DerSchweigefuchs/uC_Agri-PV/Bibliothek/ESP32-C6-WROOM-1-N8/ESP32-C6-WROOM-1-N8.step

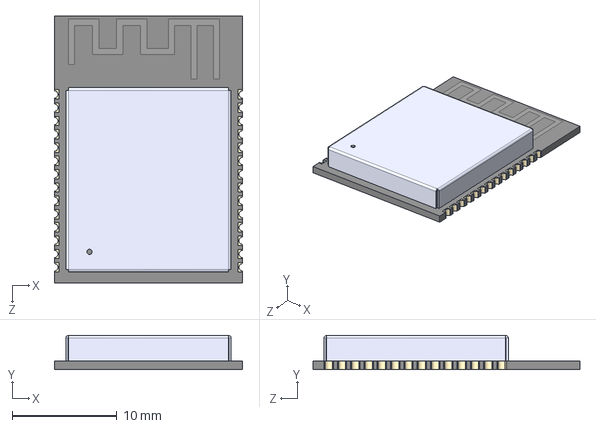
[picture p10: CAD file, 2025-12-17]
Bibliothek/ESP32-C6-WROOM-1-N8/ESP32-C6-WROOM-1-N8.step
18.0 x 3.25 x 25.5 mm
