DerSchweigefuchs/uC_Agri-PV/Bibliothek/FC0V104ZFTBR24/3D/FC0V104ZFTBR24.stp

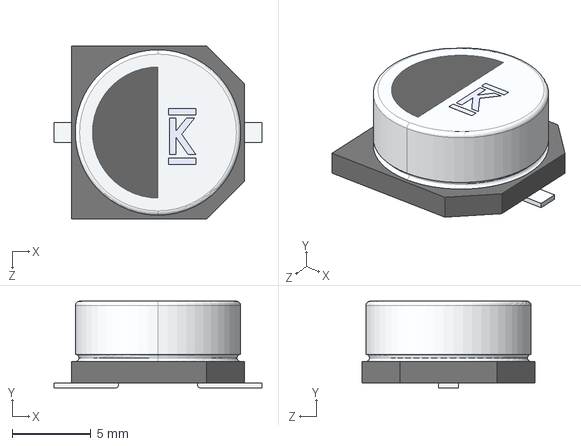
[picture p11: CAD file, 2026-01-08]
Bibliothek/FC0V104ZFTBR24/3D/FC0V104ZFTBR24.stp
13.2 x 5.50 x 11.0 mm
