DerSchweigefuchs/uC_Agri-PV/Bibliothek/LIB_BD125-10-A-0305-0580-L-B/BD125-10-A-0305-0580-L-B/3D/BD125-10-A-0305-0580-L-B.stp

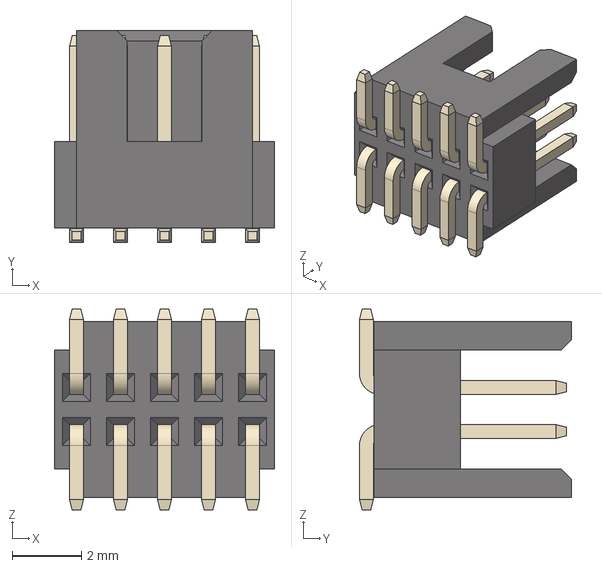
[picture p12: CAD file, 2025-12-17]
Bibliothek/LIB_BD125-10-A-0305-0580-L-B/BD125-10-A-0305-0580-L-B/3D/BD125-10-A-0305-0580-L-B.stp
6.35 x 6.12 x 5.80 mm
BD125-10-A-0305-0580-L-B_H
BD125-10-A-0305-0580-L-B_P x 10
