DerSchweigefuchs/uC_Agri-PV/Bibliothek/LIB_CONSMA001-SMD-G-T/CONSMA001-SMD-G-T/3D/CONSMA001-SMD-G-T.stp

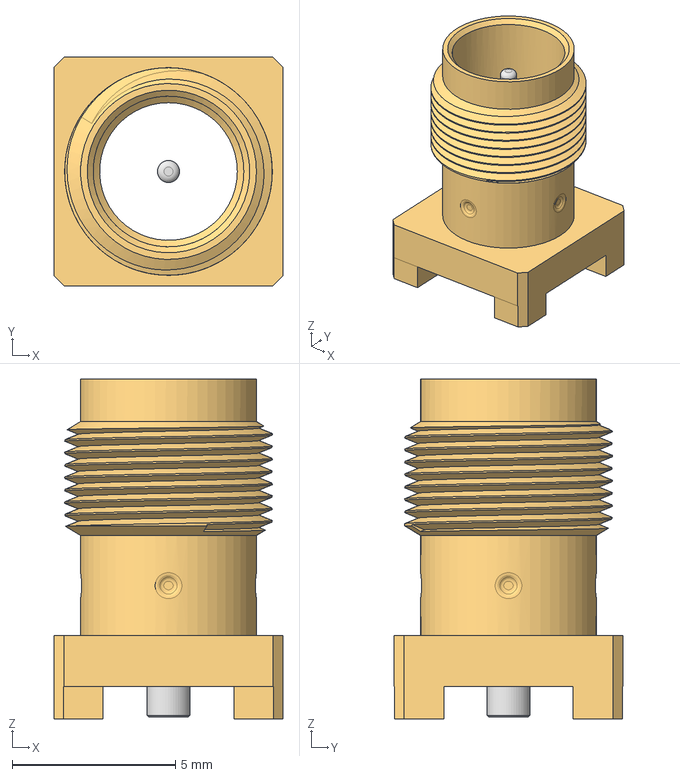
[picture p13: CAD file, 2025-12-17]
Bibliothek/LIB_CONSMA001-SMD-G-T/CONSMA001-SMD-G-T/3D/CONSMA001-SMD-G-T.stp
7.00 x 7.00 x 10.4 mm
