DerSchweigefuchs/uC_Agri-PV/Bibliothek/LIB_DMG1012T-13/DMG1012T-13/3D/DMG1012T-13.stp

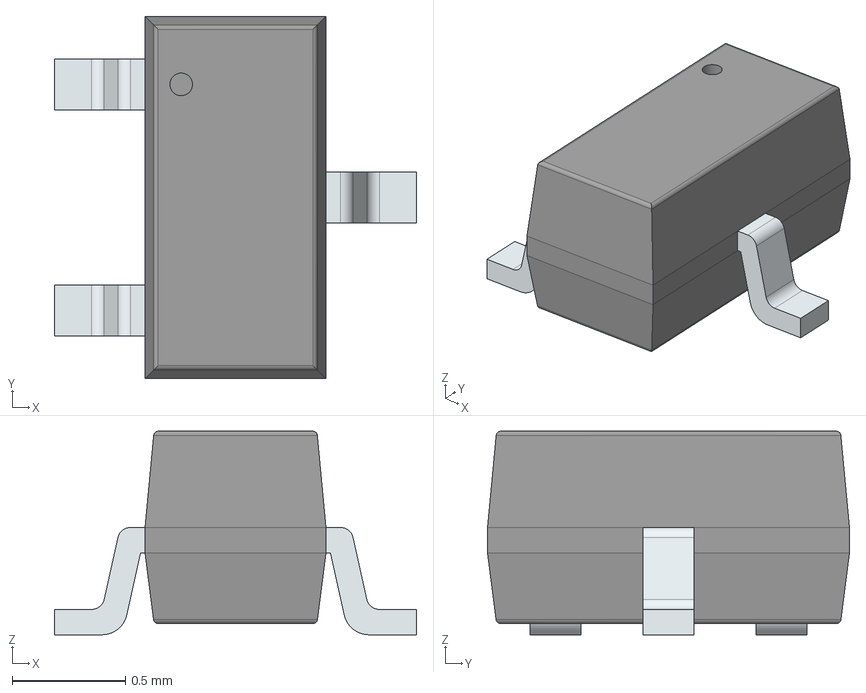
[picture p14: CAD file, 2025-12-17]
Bibliothek/LIB_DMG1012T-13/DMG1012T-13/3D/DMG1012T-13.stp
1.60 x 1.60 x 0.9 mm
PinsArrayL
FilletPinR
