DerSchweigefuchs/uC_Agri-PV/Bibliothek/LIB_DMP1045U-7/DMP1045U-7/3D/DMP1045U-7.stp

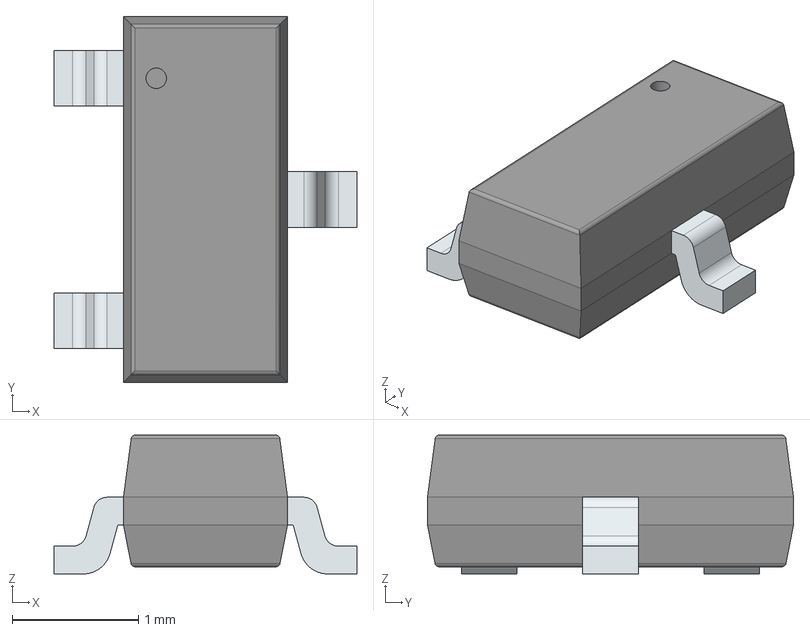
[picture p15: CAD file, 2026-01-08]
Bibliothek/LIB_DMP1045U-7/DMP1045U-7/3D/DMP1045U-7.stp
2.40 x 2.90 x 1.10 mm
PinsArrayL
FilletPinR
