DerSchweigefuchs/uC_Agri-PV/Bibliothek/LIB_ESDALC6V1W5/ESDALC6V1W5/3D/ESDALC6V1W5.stp

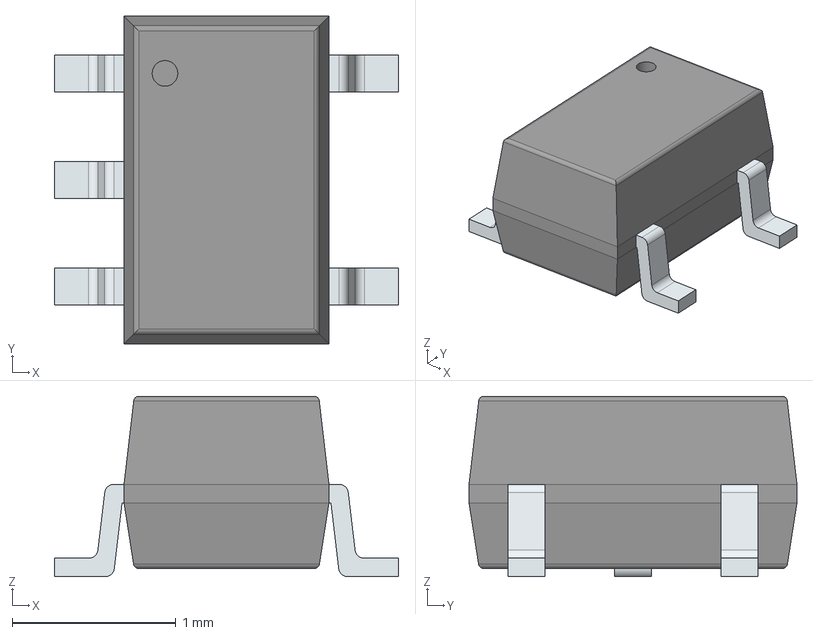
[picture p16: CAD file, 2025-12-17]
Bibliothek/LIB_ESDALC6V1W5/ESDALC6V1W5/3D/ESDALC6V1W5.stp
2.10 x 2.00 x 1.10 mm
PinsArrayL
PinsArrayR
