DerSchweigefuchs/uC_Agri-PV/Bibliothek/LIB_MMS9013-L-TP/MMS9013-L-TP/3D/MMS9013-L-TP.stp

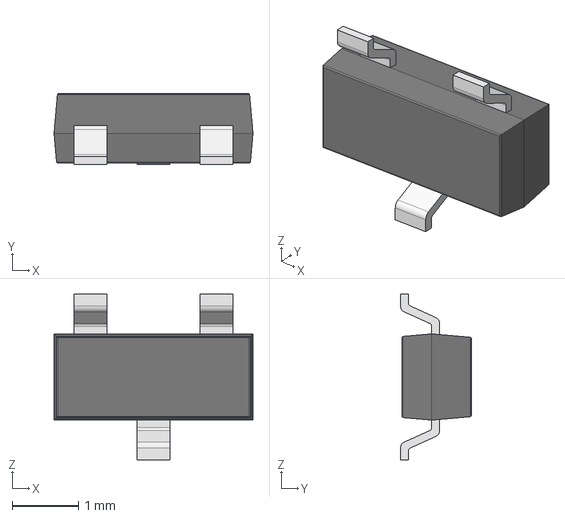
[picture p17: CAD file, 2025-12-17]
Bibliothek/LIB_MMS9013-L-TP/MMS9013-L-TP/3D/MMS9013-L-TP.stp
3.00 x 1.07 x 2.50 mm
��1
��2
