DerSchweigefuchs/uC_Agri-PV/Bibliothek/LIB_NX1610SA_32/NX1610SA_32.768000kHz/3D/NX1610SA_32.768000kHz.stp

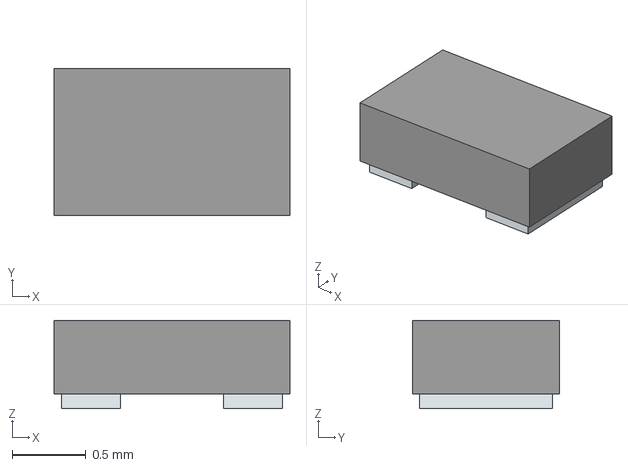
[picture p18: CAD file, 2026-01-08]
Bibliothek/LIB_NX1610SA_32/NX1610SA_32.768000kHz/3D/NX1610SA_32.768000kHz.stp
1.60 x 1.00 x 0.6 mm
Pins
