DerSchweigefuchs/uC_Agri-PV/Bibliothek/LIB_NX2016SA-26MHZ-EXS00A-CS06025/NX2016SA-26MHZ-EXS00A-CS06025/3D/NX2016SA-26MHZ-EXS00A-CS06025.stp

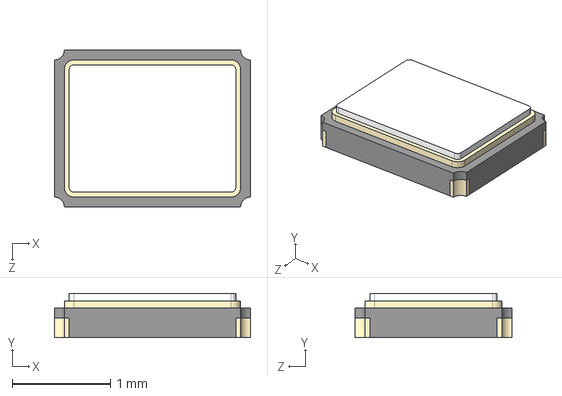
[picture p19: CAD file, 2025-12-17]
Bibliothek/LIB_NX2016SA-26MHZ-EXS00A-CS06025/NX2016SA-26MHZ-EXS00A-CS06025/3D/NX2016SA-26MHZ-EXS00A-CS06025.stp
2.00 x 0.45 x 1.60 mm
