DerSchweigefuchs/uC_Agri-PV/Bibliothek/LIB_PJ-102B (1)/PJ-102B/3D/PJ-102B.stp

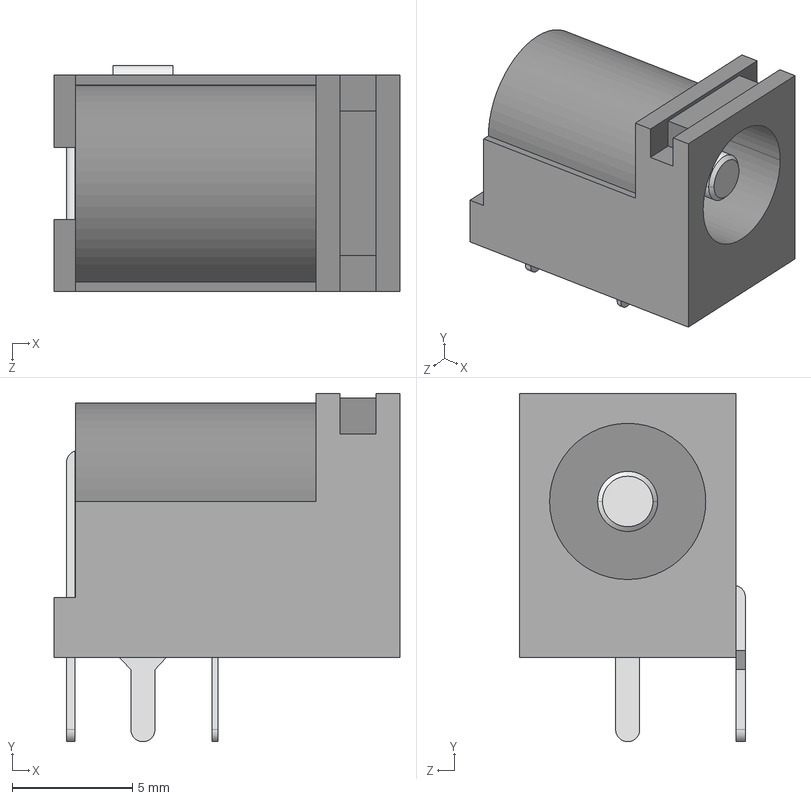
[picture p20: CAD file, 2025-12-17]
Bibliothek/LIB_PJ-102B (1)/PJ-102B/3D/PJ-102B.stp
14.4 x 14.5 x 9.40 mm
