DerSchweigefuchs/uC_Agri-PV/Bibliothek/LIB_TLV9304IDR/TLV9304IDR/3D/TLV9304IDR.stp

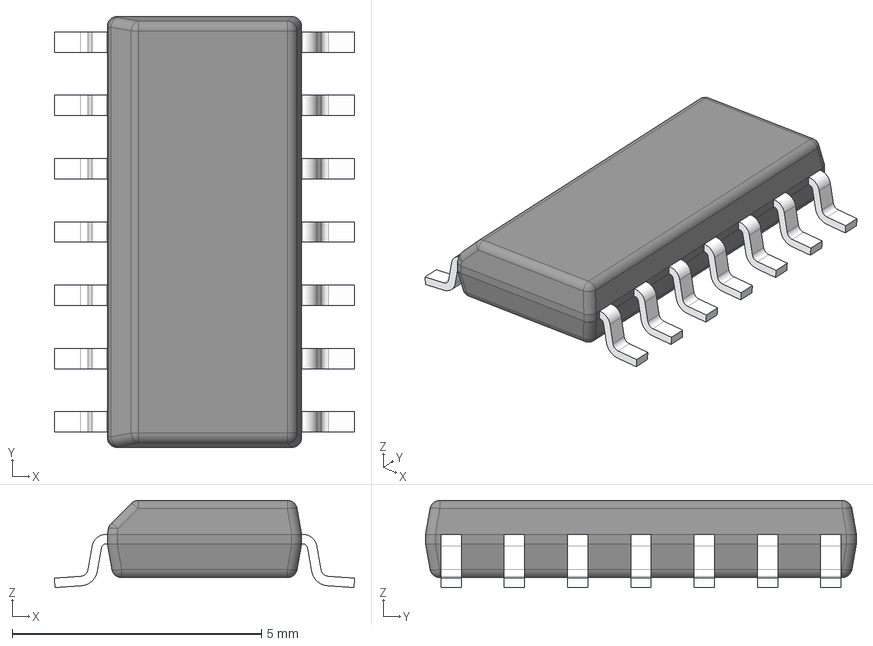
[picture p21: CAD file, 2025-12-17]
Bibliothek/LIB_TLV9304IDR/TLV9304IDR/3D/TLV9304IDR.stp
6.03 x 8.65 x 1.75 mm
BODY-SO
LEAD-SO x 14
PIN1-ID
