DerSchweigefuchs/uC_Agri-PV/Bibliothek/TPS61023DRLR/DRL0006A.stp

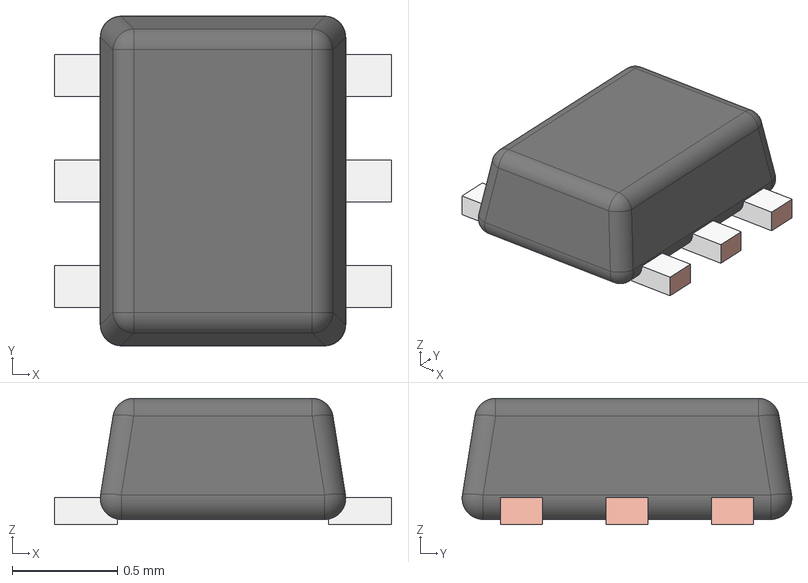
[picture p22: CAD file, 2026-01-08]
Bibliothek/TPS61023DRLR/DRL0006A.stp
1.60 x 1.57 x 0.6 mm
FRAME-DRL0006A
BODY-SOT
PIN1-ID
