DerSchweigefuchs/uC_Agri-PV/Bibliothek/317990687/3D/317990687.stp

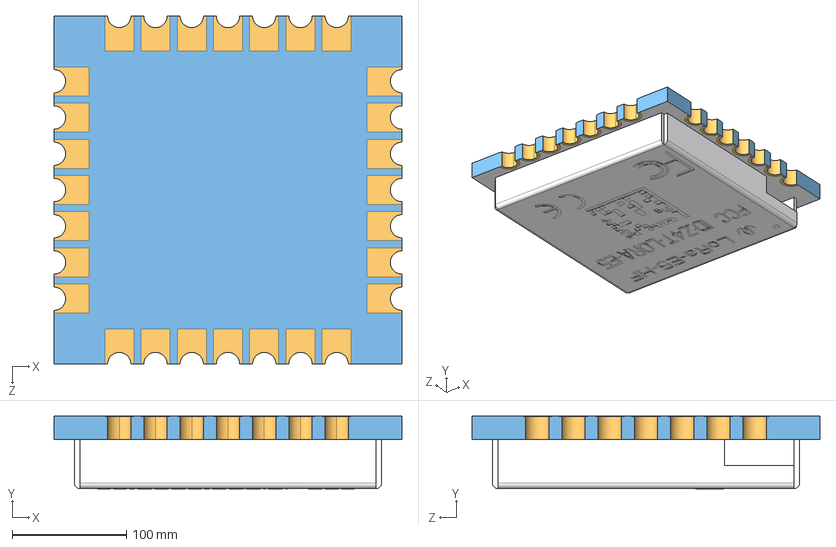
[picture p23: CAD file, 2025-12-17]
Bibliothek/317990687/3D/317990687.stp
304.8 x 63.8 x 304.8 mm
