DerSchweigefuchs/uC_Agri-PV/Bibliothek/317990687/KiCADv6/503398-1892.stp

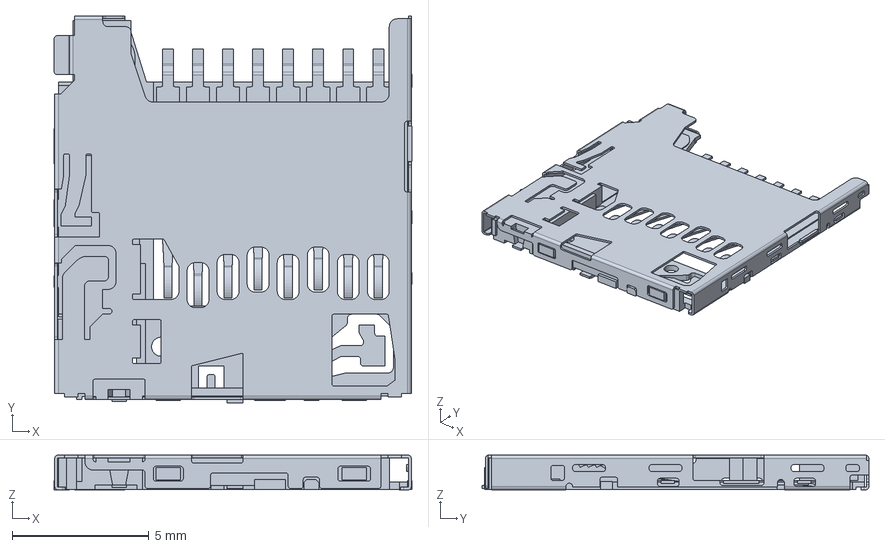
[picture p24: CAD file, 2025-12-17]
Bibliothek/317990687/KiCADv6/503398-1892.stp
13.1 x 14.2 x 1.28 mm
