DerSchweigefuchs/uC_Agri-PV/Bibliothek/JS102011JCQN/JS102011JCQN.step

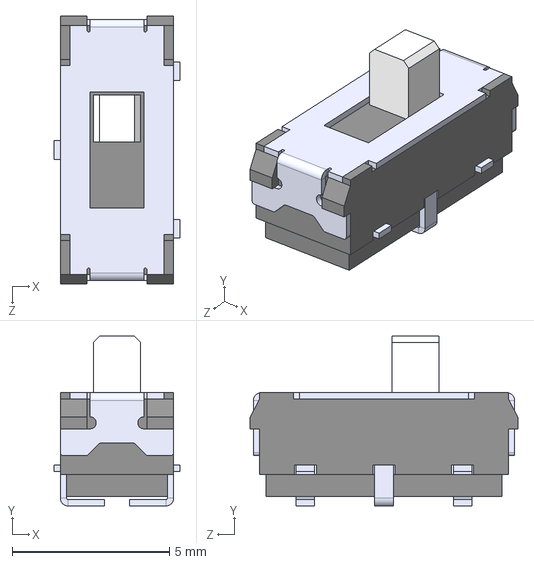
[picture p25: CAD file, 2025-12-17]
Bibliothek/JS102011JCQN/JS102011JCQN.step
4.00 x 5.40 x 8.50 mm
