DerSchweigefuchs/uC_Agri-PV/Bibliothek/LIB_ISL83078EIBZA/ISL83078EIBZA/3D/ISL83078EIBZA.stp

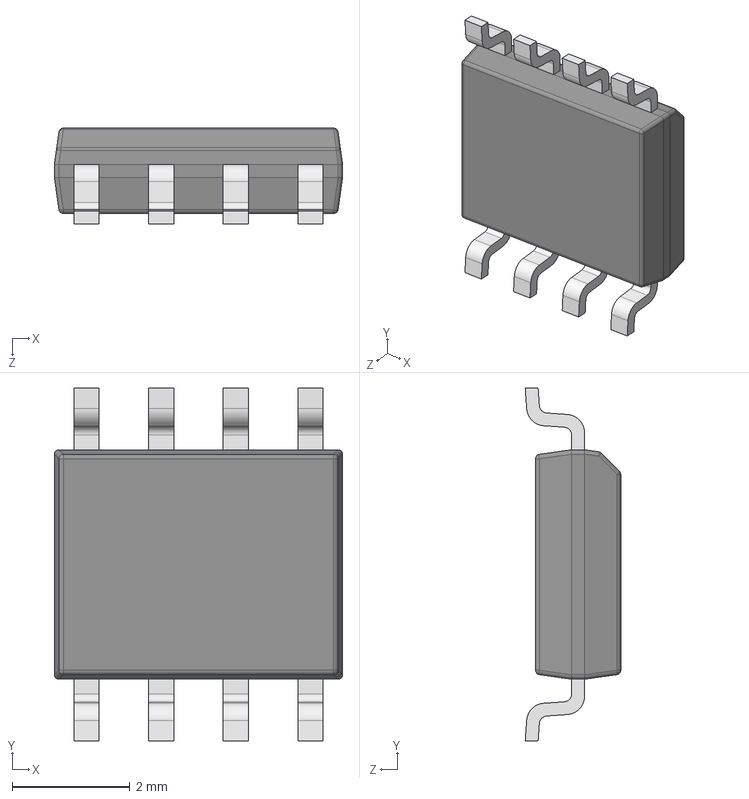
[picture p26: CAD file, 2025-12-17]
Bibliothek/LIB_ISL83078EIBZA/ISL83078EIBZA/3D/ISL83078EIBZA.stp
4.90 x 6.00 x 1.62 mm
