DerSchweigefuchs/uC_Agri-PV/Bibliothek/LIB_TPS63021DSJR/TPS63021DSJR/3D/TPS63021DSJR.stp

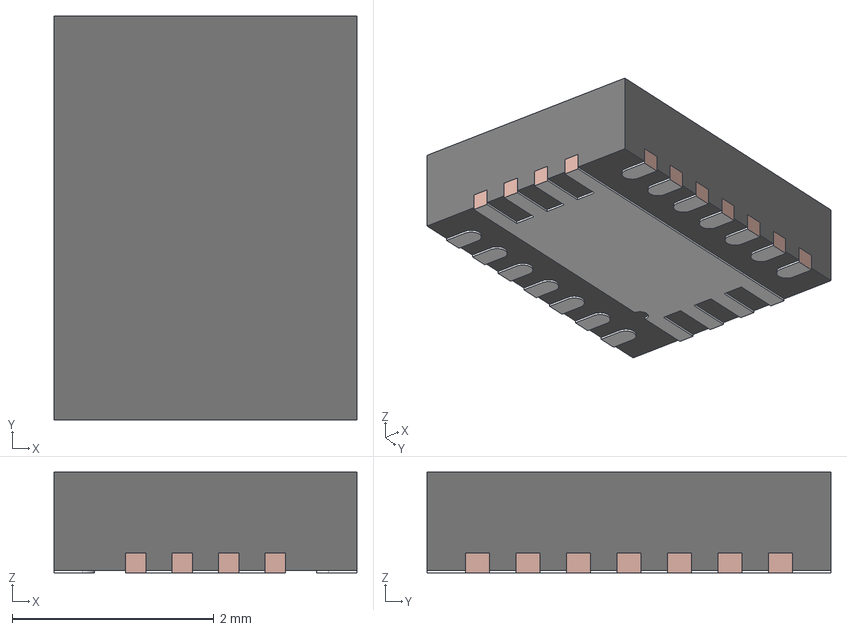
[picture p27: CAD file, 2025-12-17]
Bibliothek/LIB_TPS63021DSJR/TPS63021DSJR/3D/TPS63021DSJR.stp
3.00 x 4.00 x 1.00 mm
FRAME
MOLD
