DerSchweigefuchs/uC_Agri-PV/(list of files, cad)

Other CAD files:
Bibliothek/317990687/DEHDL/317990687/chips/chips.prt
Bibliothek/FC0V104ZFTBR24/Allegro/capae1080x550n.psm
Bibliothek/FC0V104ZFTBR24/DEHDL/fc0v104zftbr24/chips/chips.prt
Bibliothek/LIB_3266X-1-203LF/3266X-1-203LF/Allegro/3266x1203lf.psm
Bibliothek/LIB_3266X-1-203LF/3266X-1-203LF/DEHDL/3266x_1_203lf/chips/chips.prt
Bibliothek/LIB_503398-1892/503398-1892/Allegro/5033981892.psm
Bibliothek/LIB_503398-1892/503398-1892/DEHDL/503398_1892/chips/chips.prt
Bibliothek/LIB_BD125-10-A-0305-0580-L-B/BD125-10-A-0305-0580-L-B/Allegro/bd12510a03050580lb.psm
Bibliothek/LIB_BD125-10-A-0305-0580-L-B/BD125-10-A-0305-0580-L-B/DEHDL/bd125_10_a_0305_0580_l_b/chips/chips.prt
Bibliothek/LIB_CONSMA001-SMD-G-T/CONSMA001-SMD-G-T/Allegro/consma001smdgt.psm
Bibliothek/LIB_CONSMA001-SMD-G-T/CONSMA001-SMD-G-T/DEHDL/consma001_smd_g_t/chips/chips.prt
Bibliothek/LIB_DMG1012T-13/DMG1012T-13/Allegro/sot50p160x90-3n.psm
Bibliothek/LIB_DMG1012T-13/DMG1012T-13/DEHDL/dmg1012t_13/chips/chips.prt
Bibliothek/LIB_DMP1045U-7/DMP1045U-7/Allegro/sot96p240x110-3n.psm
Bibliothek/LIB_DMP1045U-7/DMP1045U-7/DEHDL/dmp1045u_7/chips/chips.prt
Bibliothek/LIB_ESDALC6V1W5/ESDALC6V1W5/Allegro/sot65p210x110-5n.psm
Bibliothek/LIB_ESDALC6V1W5/ESDALC6V1W5/DEHDL/esdalc6v1w5/chips/chips.prt
Bibliothek/LIB_ISL83078EIBZA/ISL83078EIBZA/Allegro/soic127p600x175-8n.psm
Bibliothek/LIB_ISL83078EIBZA/ISL83078EIBZA/DEHDL/isl83078eibza/chips/chips.prt
Bibliothek/LIB_MMS9013-L-TP/MMS9013-L-TP/Allegro/sot95p237x125-3n.psm
Bibliothek/LIB_MMS9013-L-TP/MMS9013-L-TP/DEHDL/mms9013_l_tp/chips/chips.prt
Bibliothek/LIB_NX1610SA_32/NX1610SA_32.768000kHz/Allegro/nx1610sa32768000khz.psm
Bibliothek/LIB_NX1610SA_32/NX1610SA_32.768000kHz/DEHDL/nx1610sa_32.768000khz/chips/chips.prt
Bibliothek/LIB_NX2016SA-26MHZ-EXS00A-CS06025/NX2016SA-26MHZ-EXS00A-CS06025/Allegro/nx2016sa-26mhz-exs00a-cs06025.psm
Bibliothek/LIB_NX2016SA-26MHZ-EXS00A-CS06025/NX2016SA-26MHZ-EXS00A-CS06025/DEHDL/nx2016sa_26mhz_exs00a_cs06025/chips/chips.prt
Bibliothek/LIB_PJ-102B (1)/PJ-102B/Allegro/pj102b.psm
Bibliothek/LIB_PJ-102B (1)/PJ-102B/DEHDL/pj_102b/chips/chips.prt
Bibliothek/LIB_TLV9304IDR/TLV9304IDR/Allegro/soic127p600x175-14n.psm
Bibliothek/LIB_TLV9304IDR/TLV9304IDR/DEHDL/tlv9304idr/chips/chips.prt
Bibliothek/LIB_TPS63021DSJR/TPS63021DSJR/Allegro/son50p300x400x100-15n-d.psm
Bibliothek/LIB_TPS63021DSJR/TPS63021DSJR/DEHDL/tps63021dsjr/chips/chips.prt
