DerSchweigefuchs/uC_Agri-PV/uC_Agri-PV.pdf

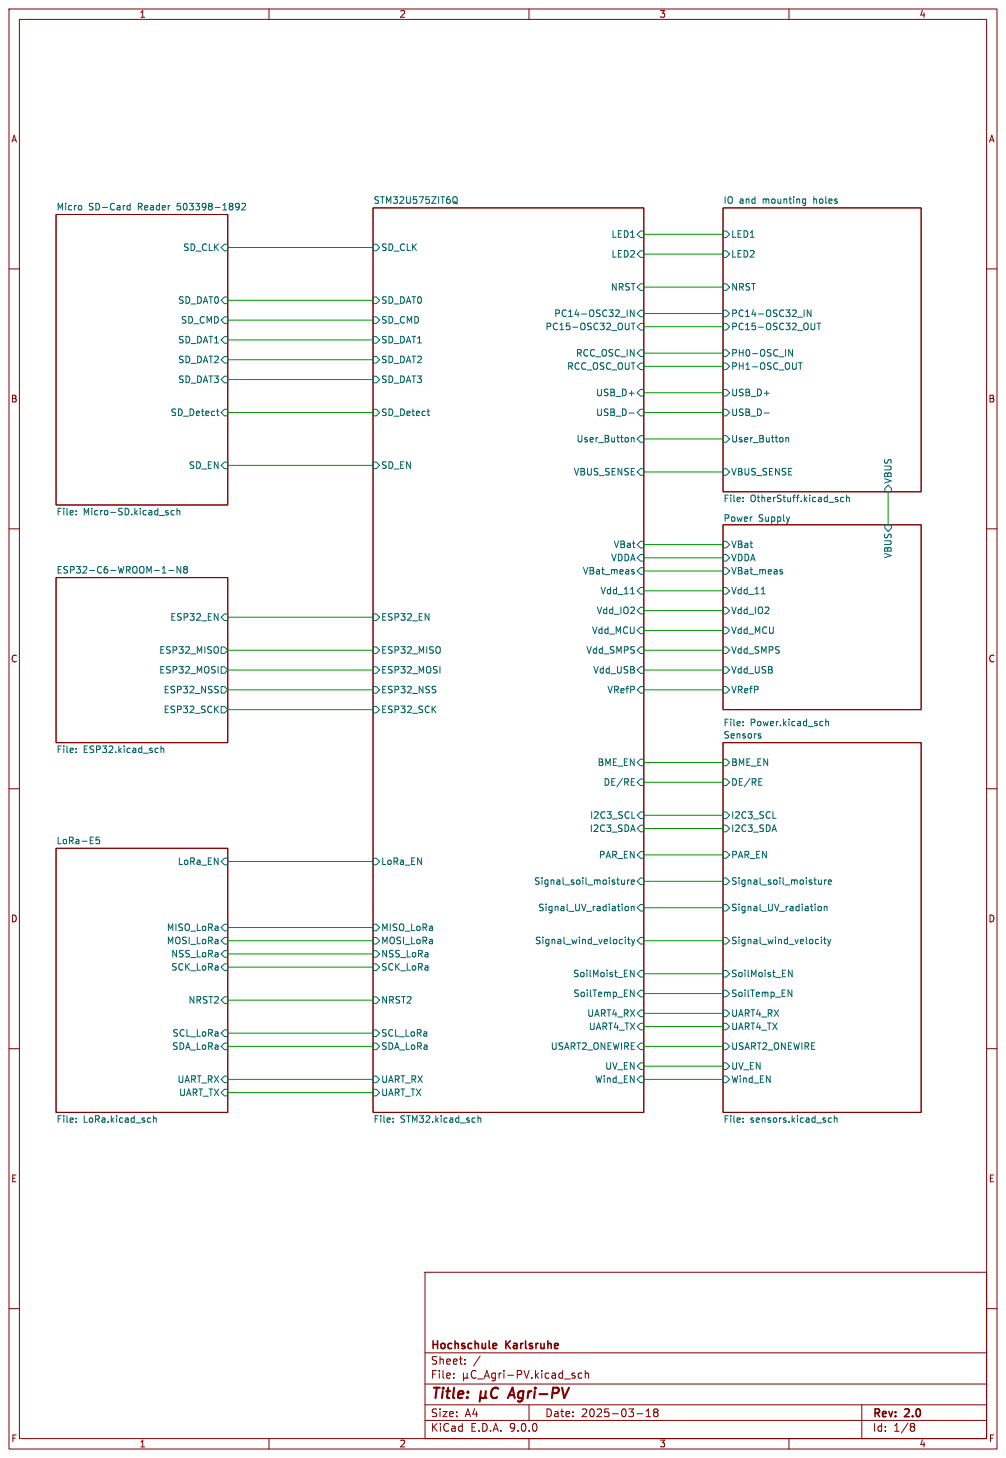
[picture p28: page 1]

Id: 1/8 Title: þÿµCAgri-PV

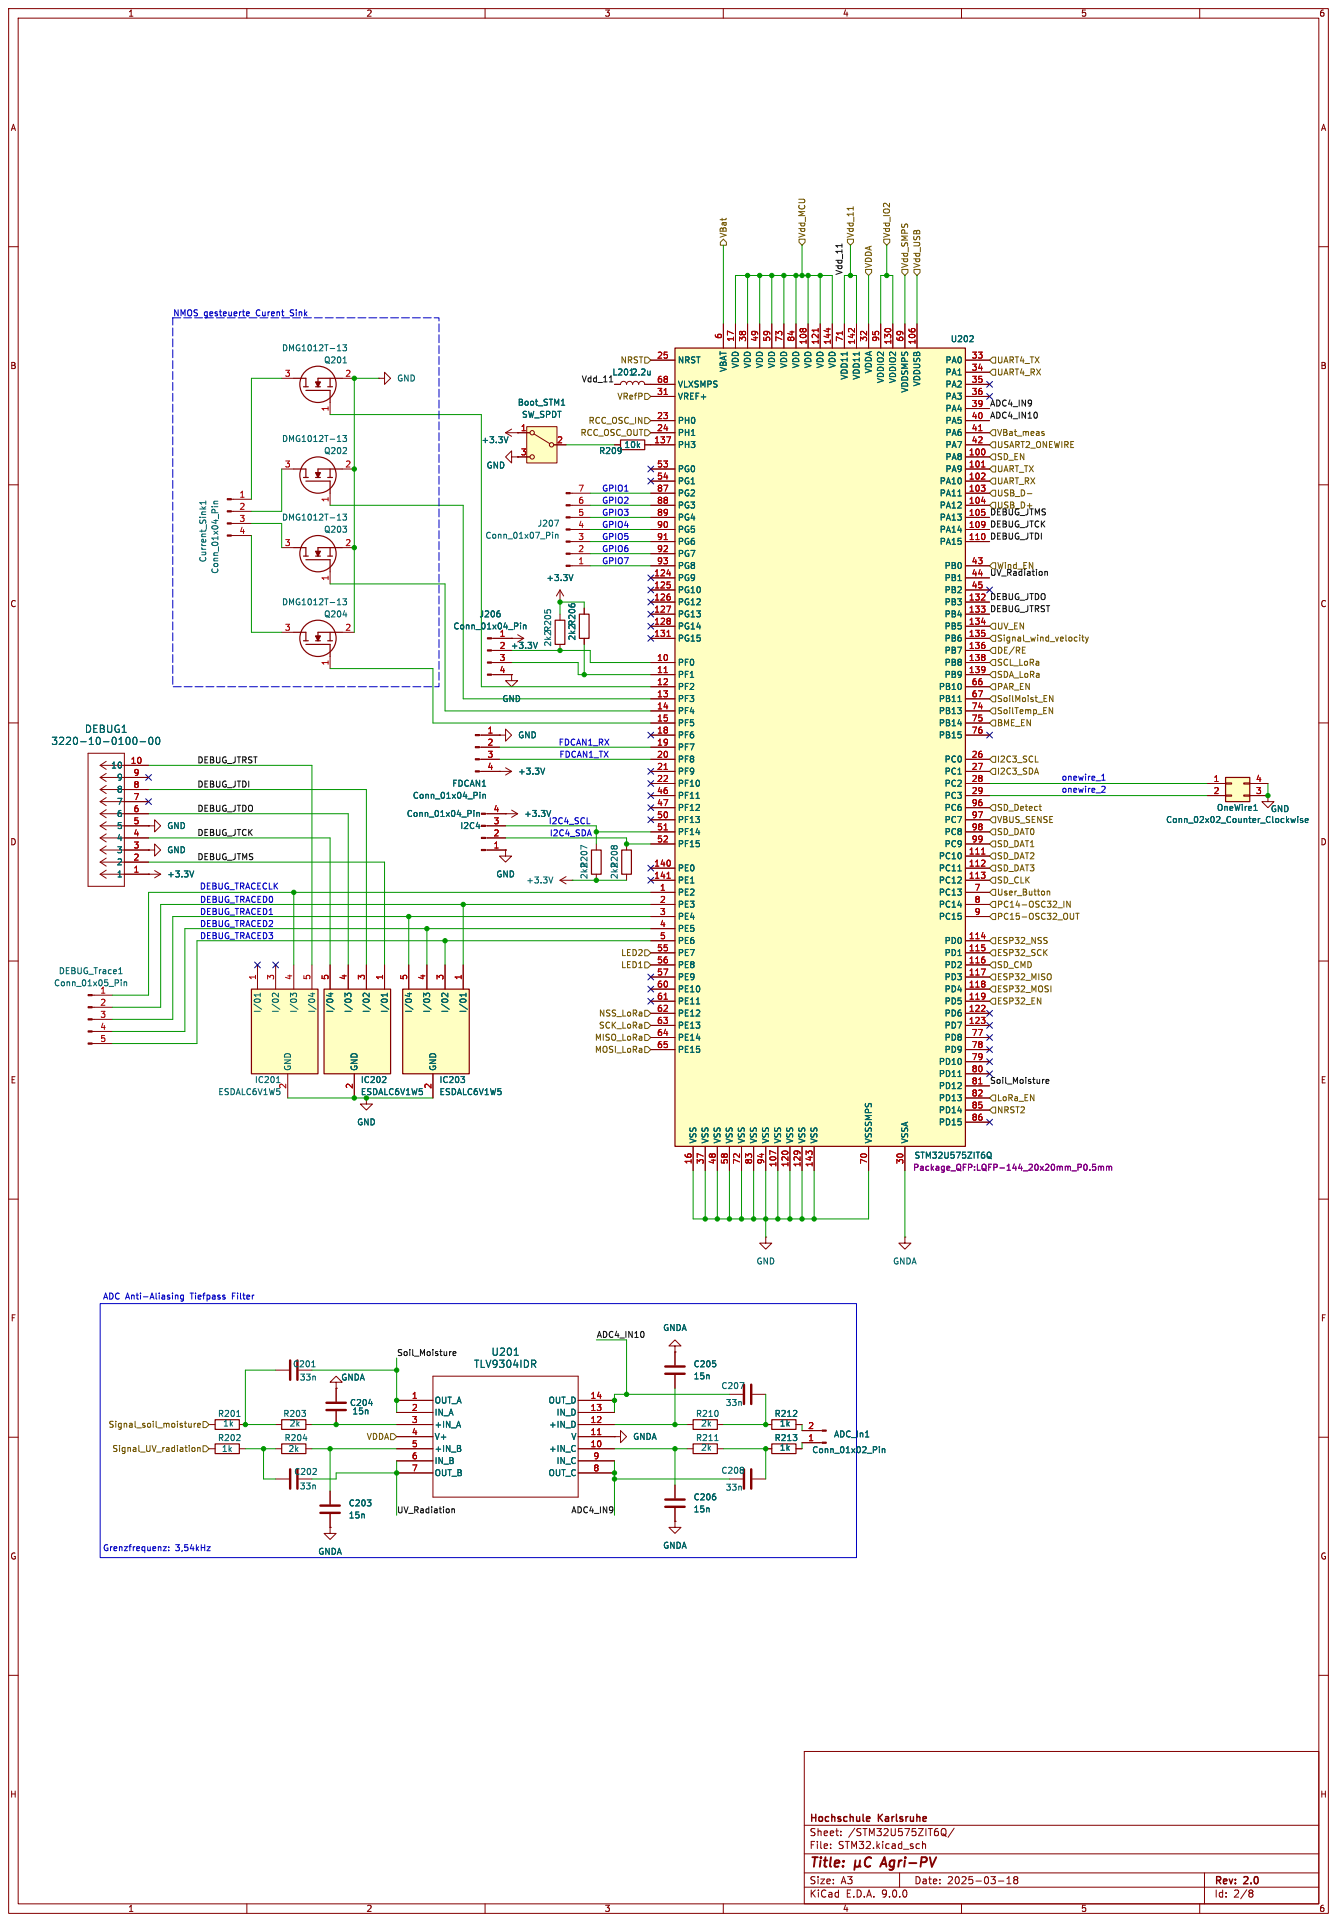
[picture p29: page 2]

6 VSS 58 VDD 17 VSS 72 VDD 38 VSS 83 VDD 49 VSS 94 VDD 59 VSS 107 VDD 73 VSS 120 VDD 84 VSS 129 VDD 108 VSS 143 VDD 121 VDD 144 VDD11 71 VDD11 142 VDDA 32 VSSSMPS 70 VDDIO2 95 VDDIO2 130 VDDSMPS 69 VSSA 30 VDDUSB 106 PA0 33 PA1 34 PA2 35 PA3 36 PA4 39 PA5 40 PA6 41 PA7 42 PA8 100 PA9 101 PA10 102 PA11 103 PA12 104 PA13 105 PA14 109 PA15 110 PB0 43 PB1 44 PB2 45 PB3 132 PB4 133 PB5 134 PB6 135 PB7 136 PB8 138 PB9 139 PB10 66 PB11 67 PB13 74 PB14 75 PB15 76 PC0 26 PC1 27 PC2 28 PC3 29 PC6 96 PC7 97 PC8 98 PC9 99 PC10 111 PC11 112 PC12 113 PC13 7 PC14 8 PC15 9 PD0 114 PD1 115 PD2 116 PD3 117 PD4 118 PD5 119 PD6 122 PD7 123 PD8 77 PD9 78 PD10 79 PD11 80 PD12 81 PD13 82 PD14 85 PD15 86

Id: 2/8 Title: þÿµCAgri-PV

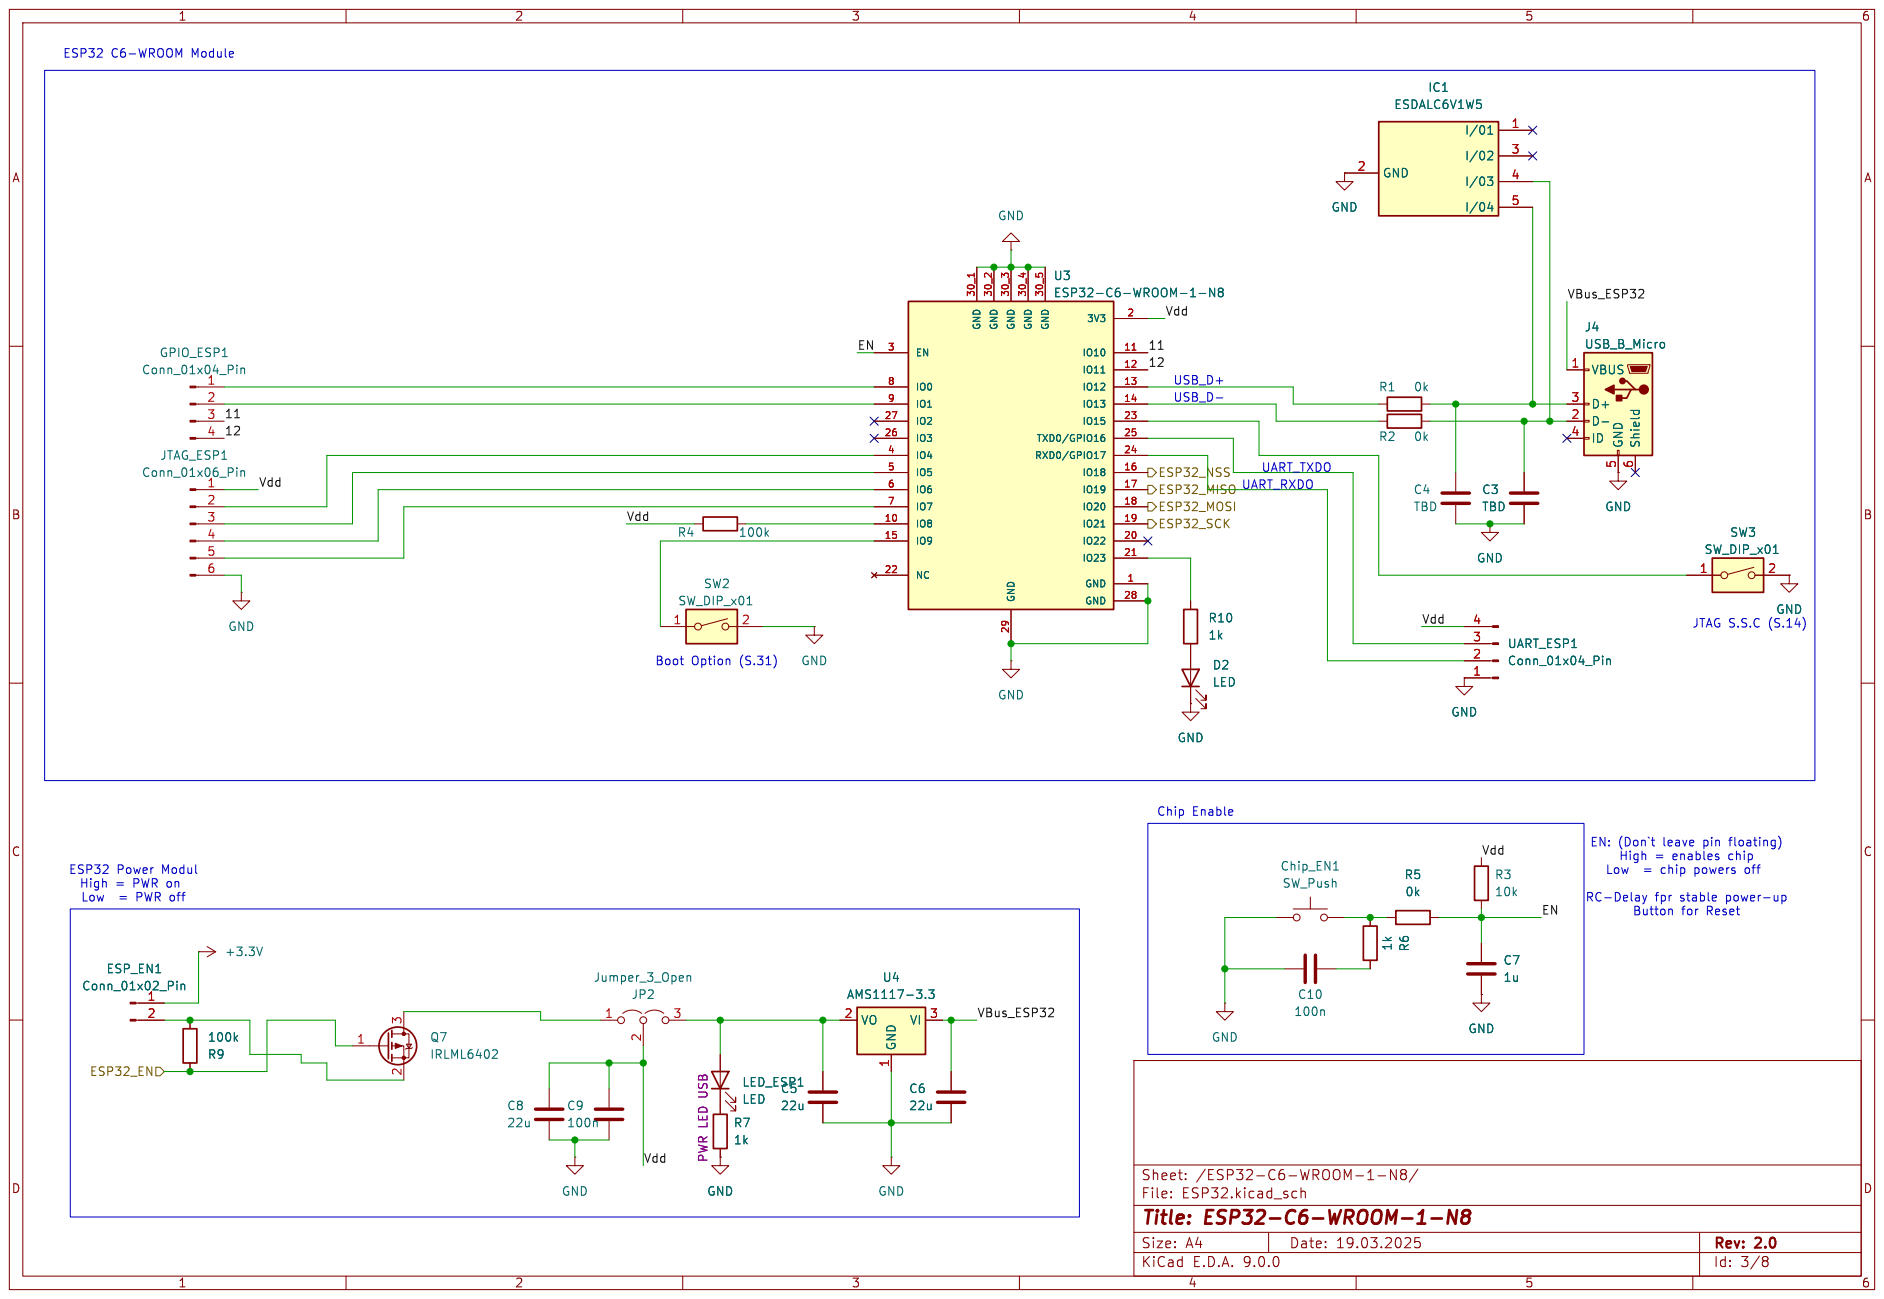
[picture p30: page 3]

Vdd ESP32 Power Modul High = PWR on

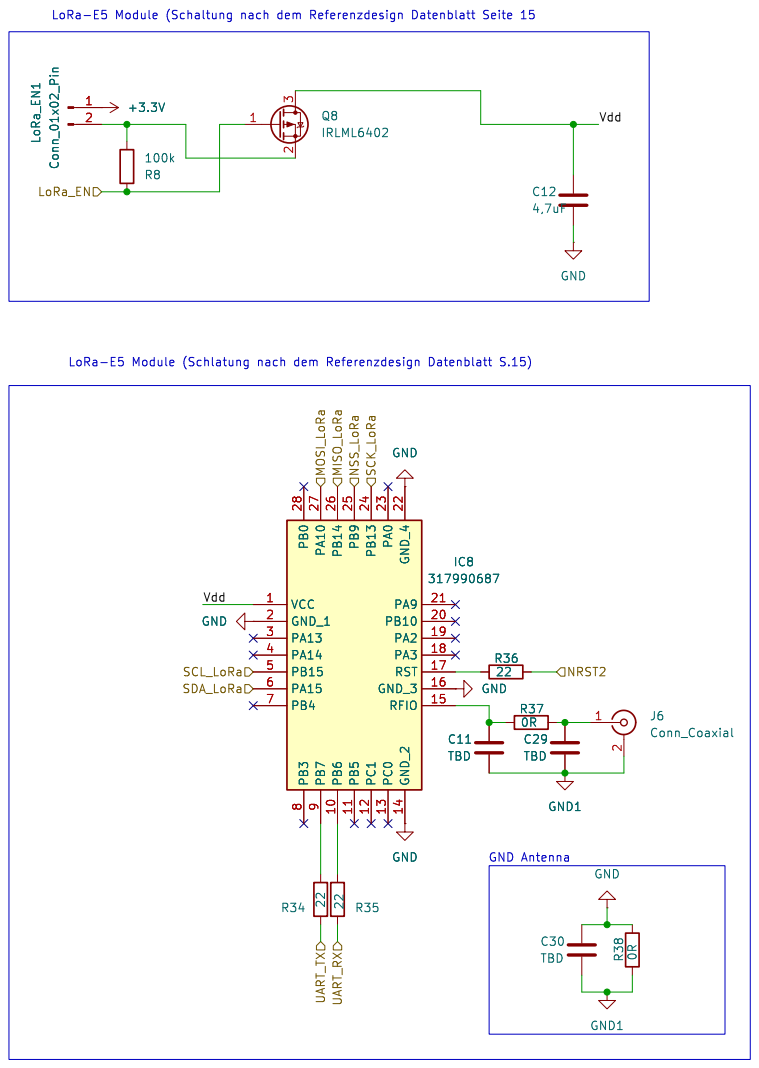
[picture p31: page 4]

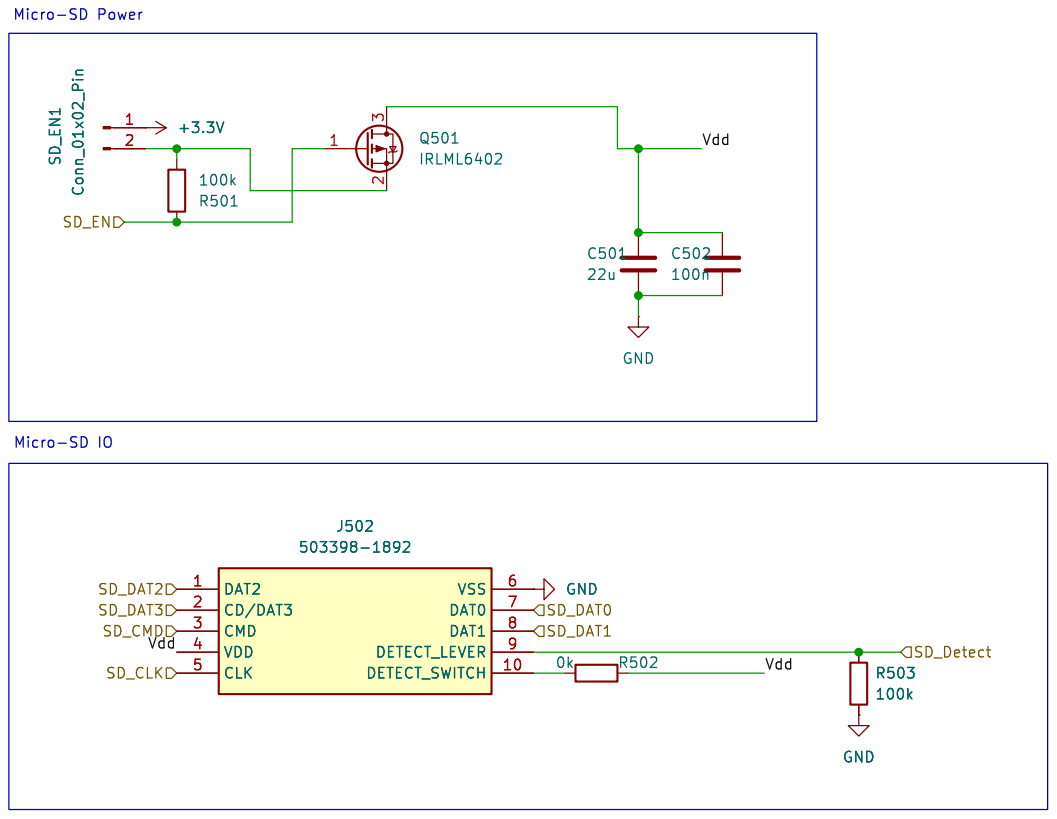
[picture p32: page 5]

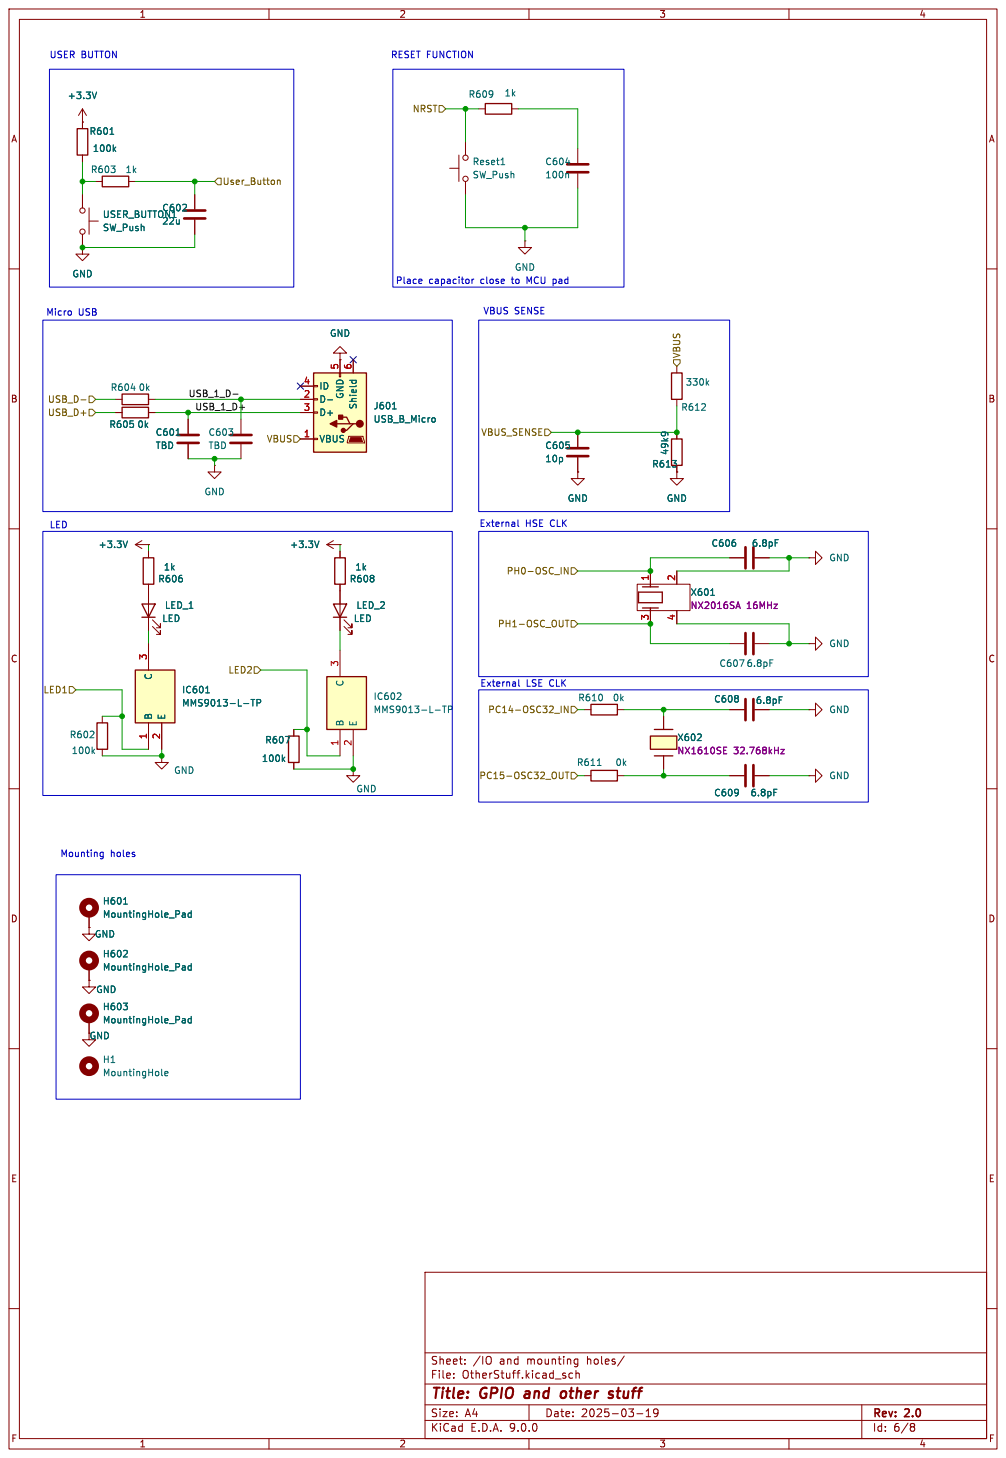
[picture p33: page 6]

External HSE CLK Mounting holes

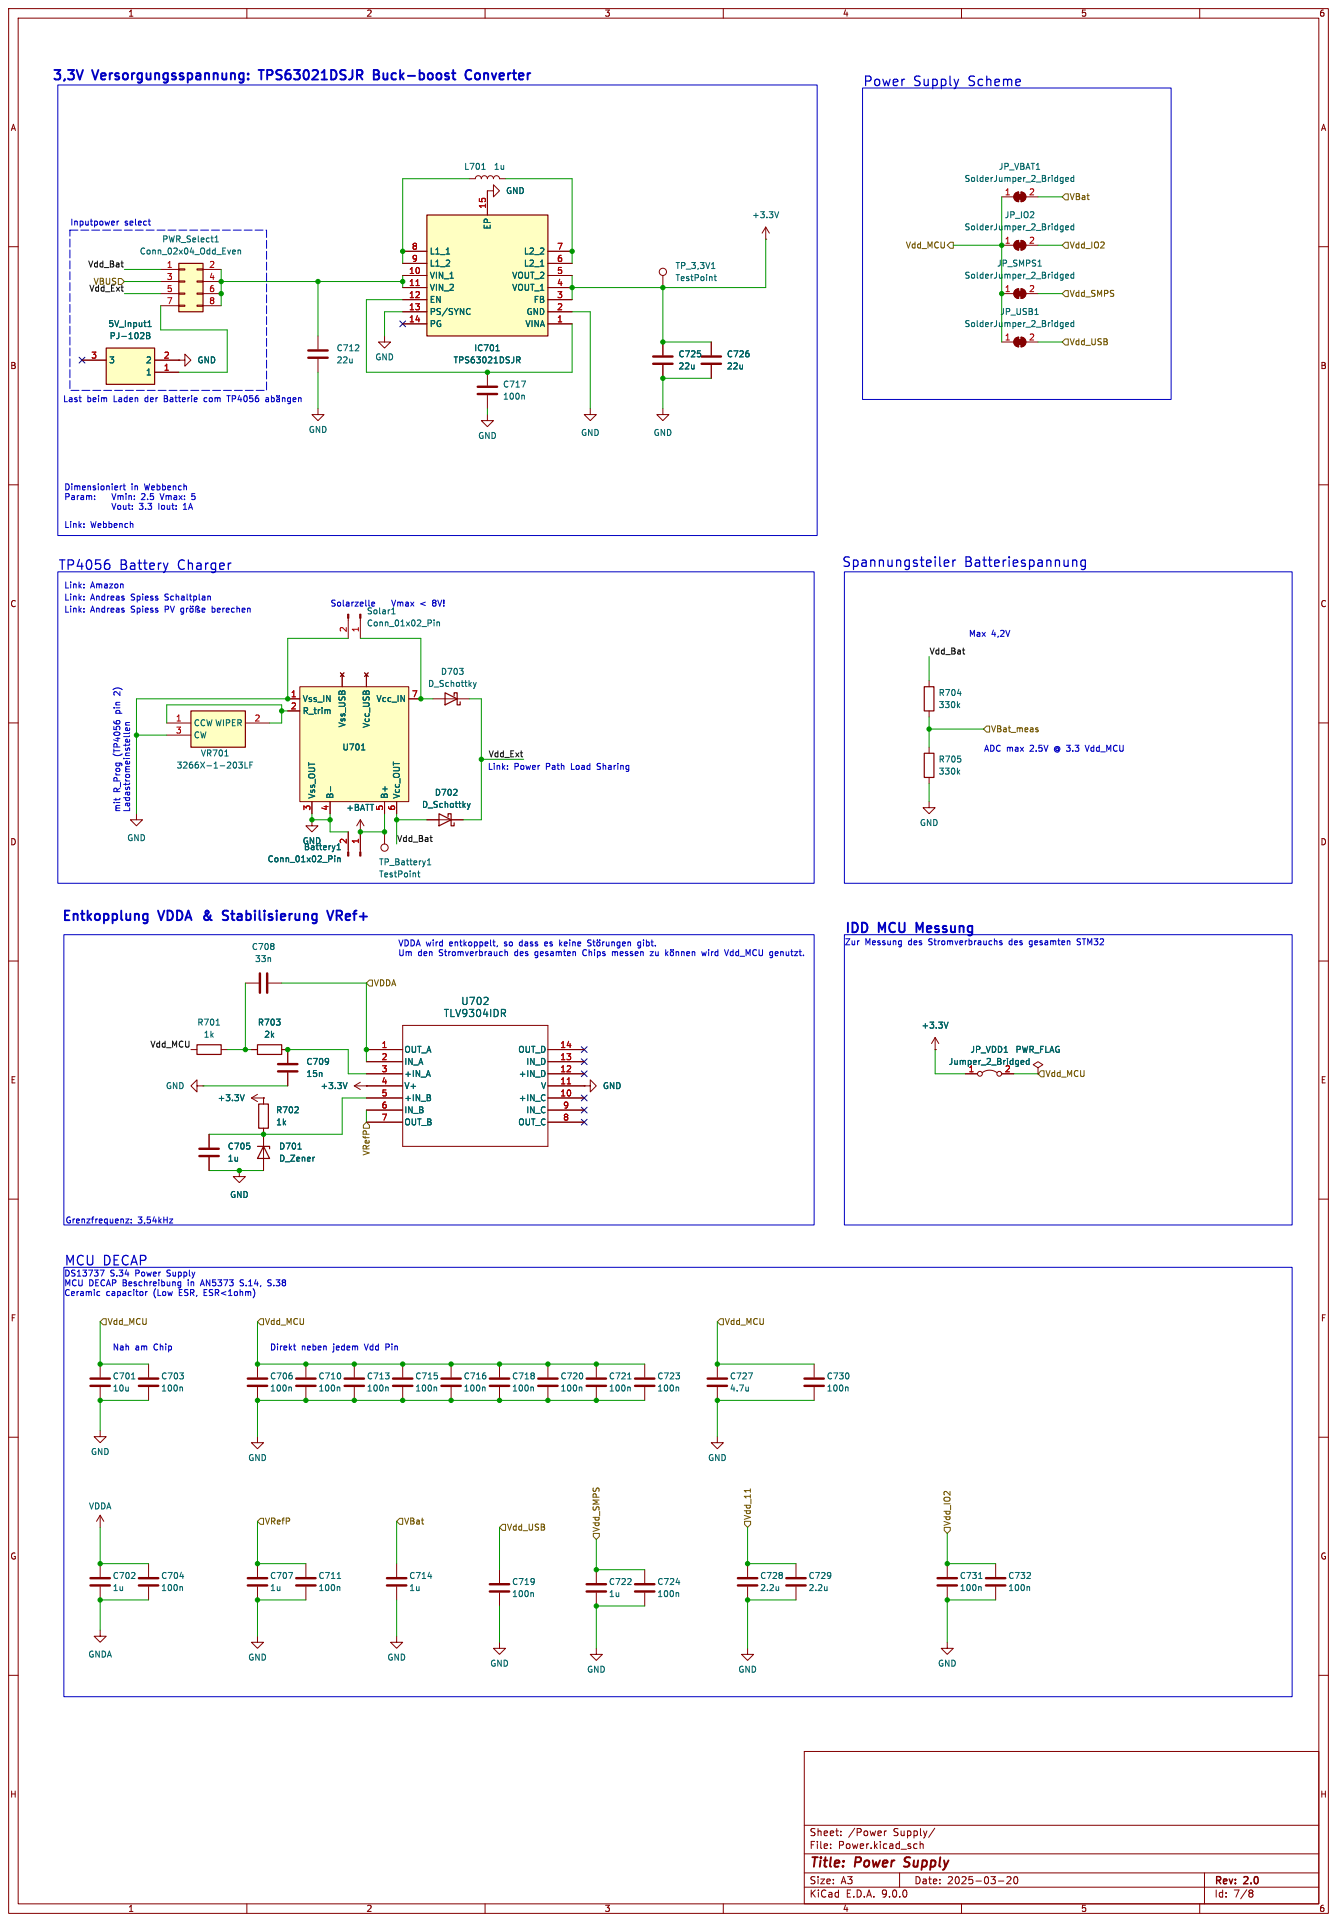
[picture p34: page 7]

Link: Amazon (https://www.amazon.de/Stemedu-Lithium-Battery-Charger-Protection-blue/dp/B0BZ4MV6G7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)
Link: Andreas Spiess Schaltplan (https://www.youtube.com/watch?v=37kGva3NW8w&list=PLNmw20C_8ZZjxo7Wl6D64O2t488Cp4NZb&index=7)

Link: Power Path Load Sharing (https://www.youtube.com/watch?v=T70mBHeIOZA) mit R_Prog (TP4056 pin 2) Ladastromeinstellen
1k GND

Id: 7/8 Title: Power Supply

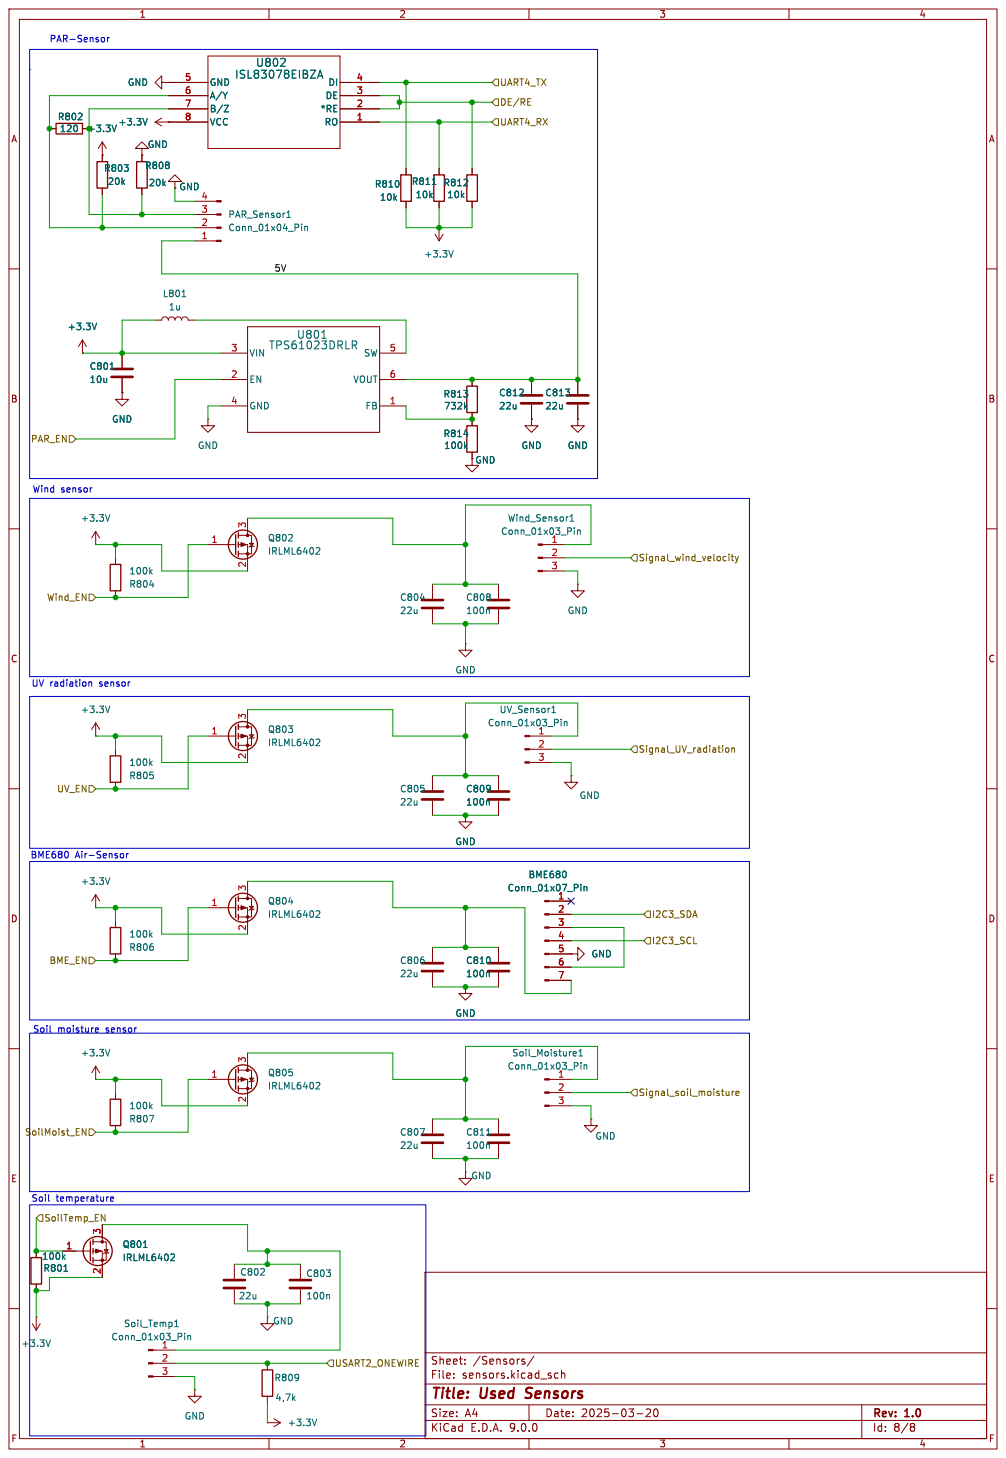
[picture p35: page 8]

File: sensors.kicad_sch Sheet: /Sensors/
Id: 8/8 Title: Used Sensors
