DerSchweigefuchs/uC_Agri-PV/uC_Agri-PV-front.pdf

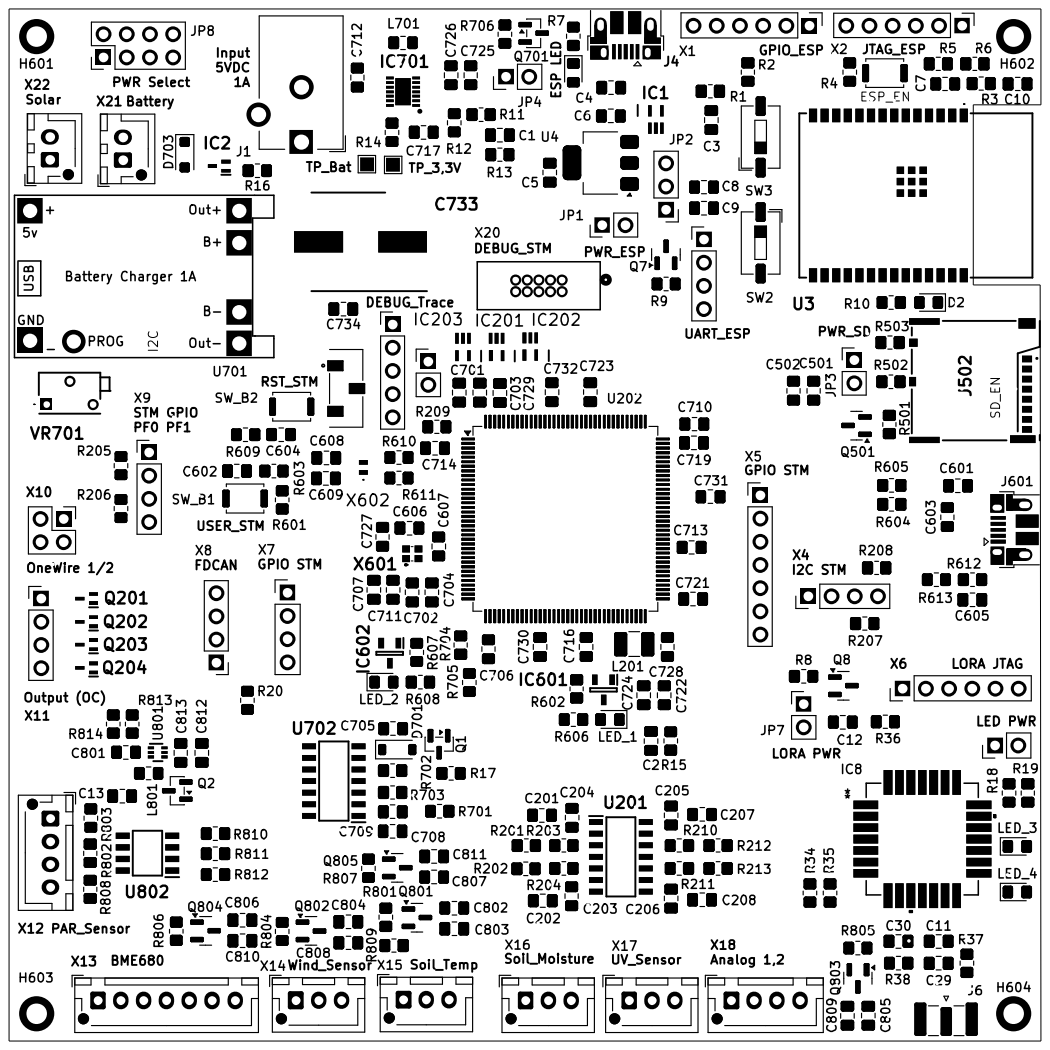
[picture p36: page 1]
