DerSchweigefuchs/uC_Agri-PV/(list of files, drawings)

Other design files:
Bibliothek/317990687/Altium/317990687.PcbLib
Bibliothek/317990687/Altium/317990687.SchLib
Bibliothek/FC0V104ZFTBR24/Altium/CAPAE1080X550N.PcbLib
Bibliothek/FC0V104ZFTBR24/Altium/FC0V104ZFTBR24.SchLib
Bibliothek/LIB_503398-1892/503398-1892/Altium/503398-1892.SchLib
Bibliothek/LIB_503398-1892/503398-1892/Altium/5033981892.PcbLib
Bibliothek/LIB_317990687/317990687/Altium/317990687.PcbLib
Bibliothek/LIB_317990687/317990687/Altium/317990687.SchLib
Bibliothek/LIB_DMP1045U-7/DMP1045U-7/Altium/DMP1045U-7.SchLib
Bibliothek/LIB_DMP1045U-7/DMP1045U-7/Altium/SOT96P240X110-3N.PcbLib
Bibliothek/LIB_NX1610SA_32/NX1610SA_32.768000kHz/Altium/NX1610SA32768000kHz.PcbLib
Bibliothek/LIB_NX1610SA_32/NX1610SA_32.768000kHz/Altium/NX1610SA_32.768000kHz.SchLib
