DerSchweigefuchs/uC_Agri-PV/uC_Agri-PV.kicad_pcb

## KiCad design uC_Agri-PV.kicad_pcb (2026-01-22)

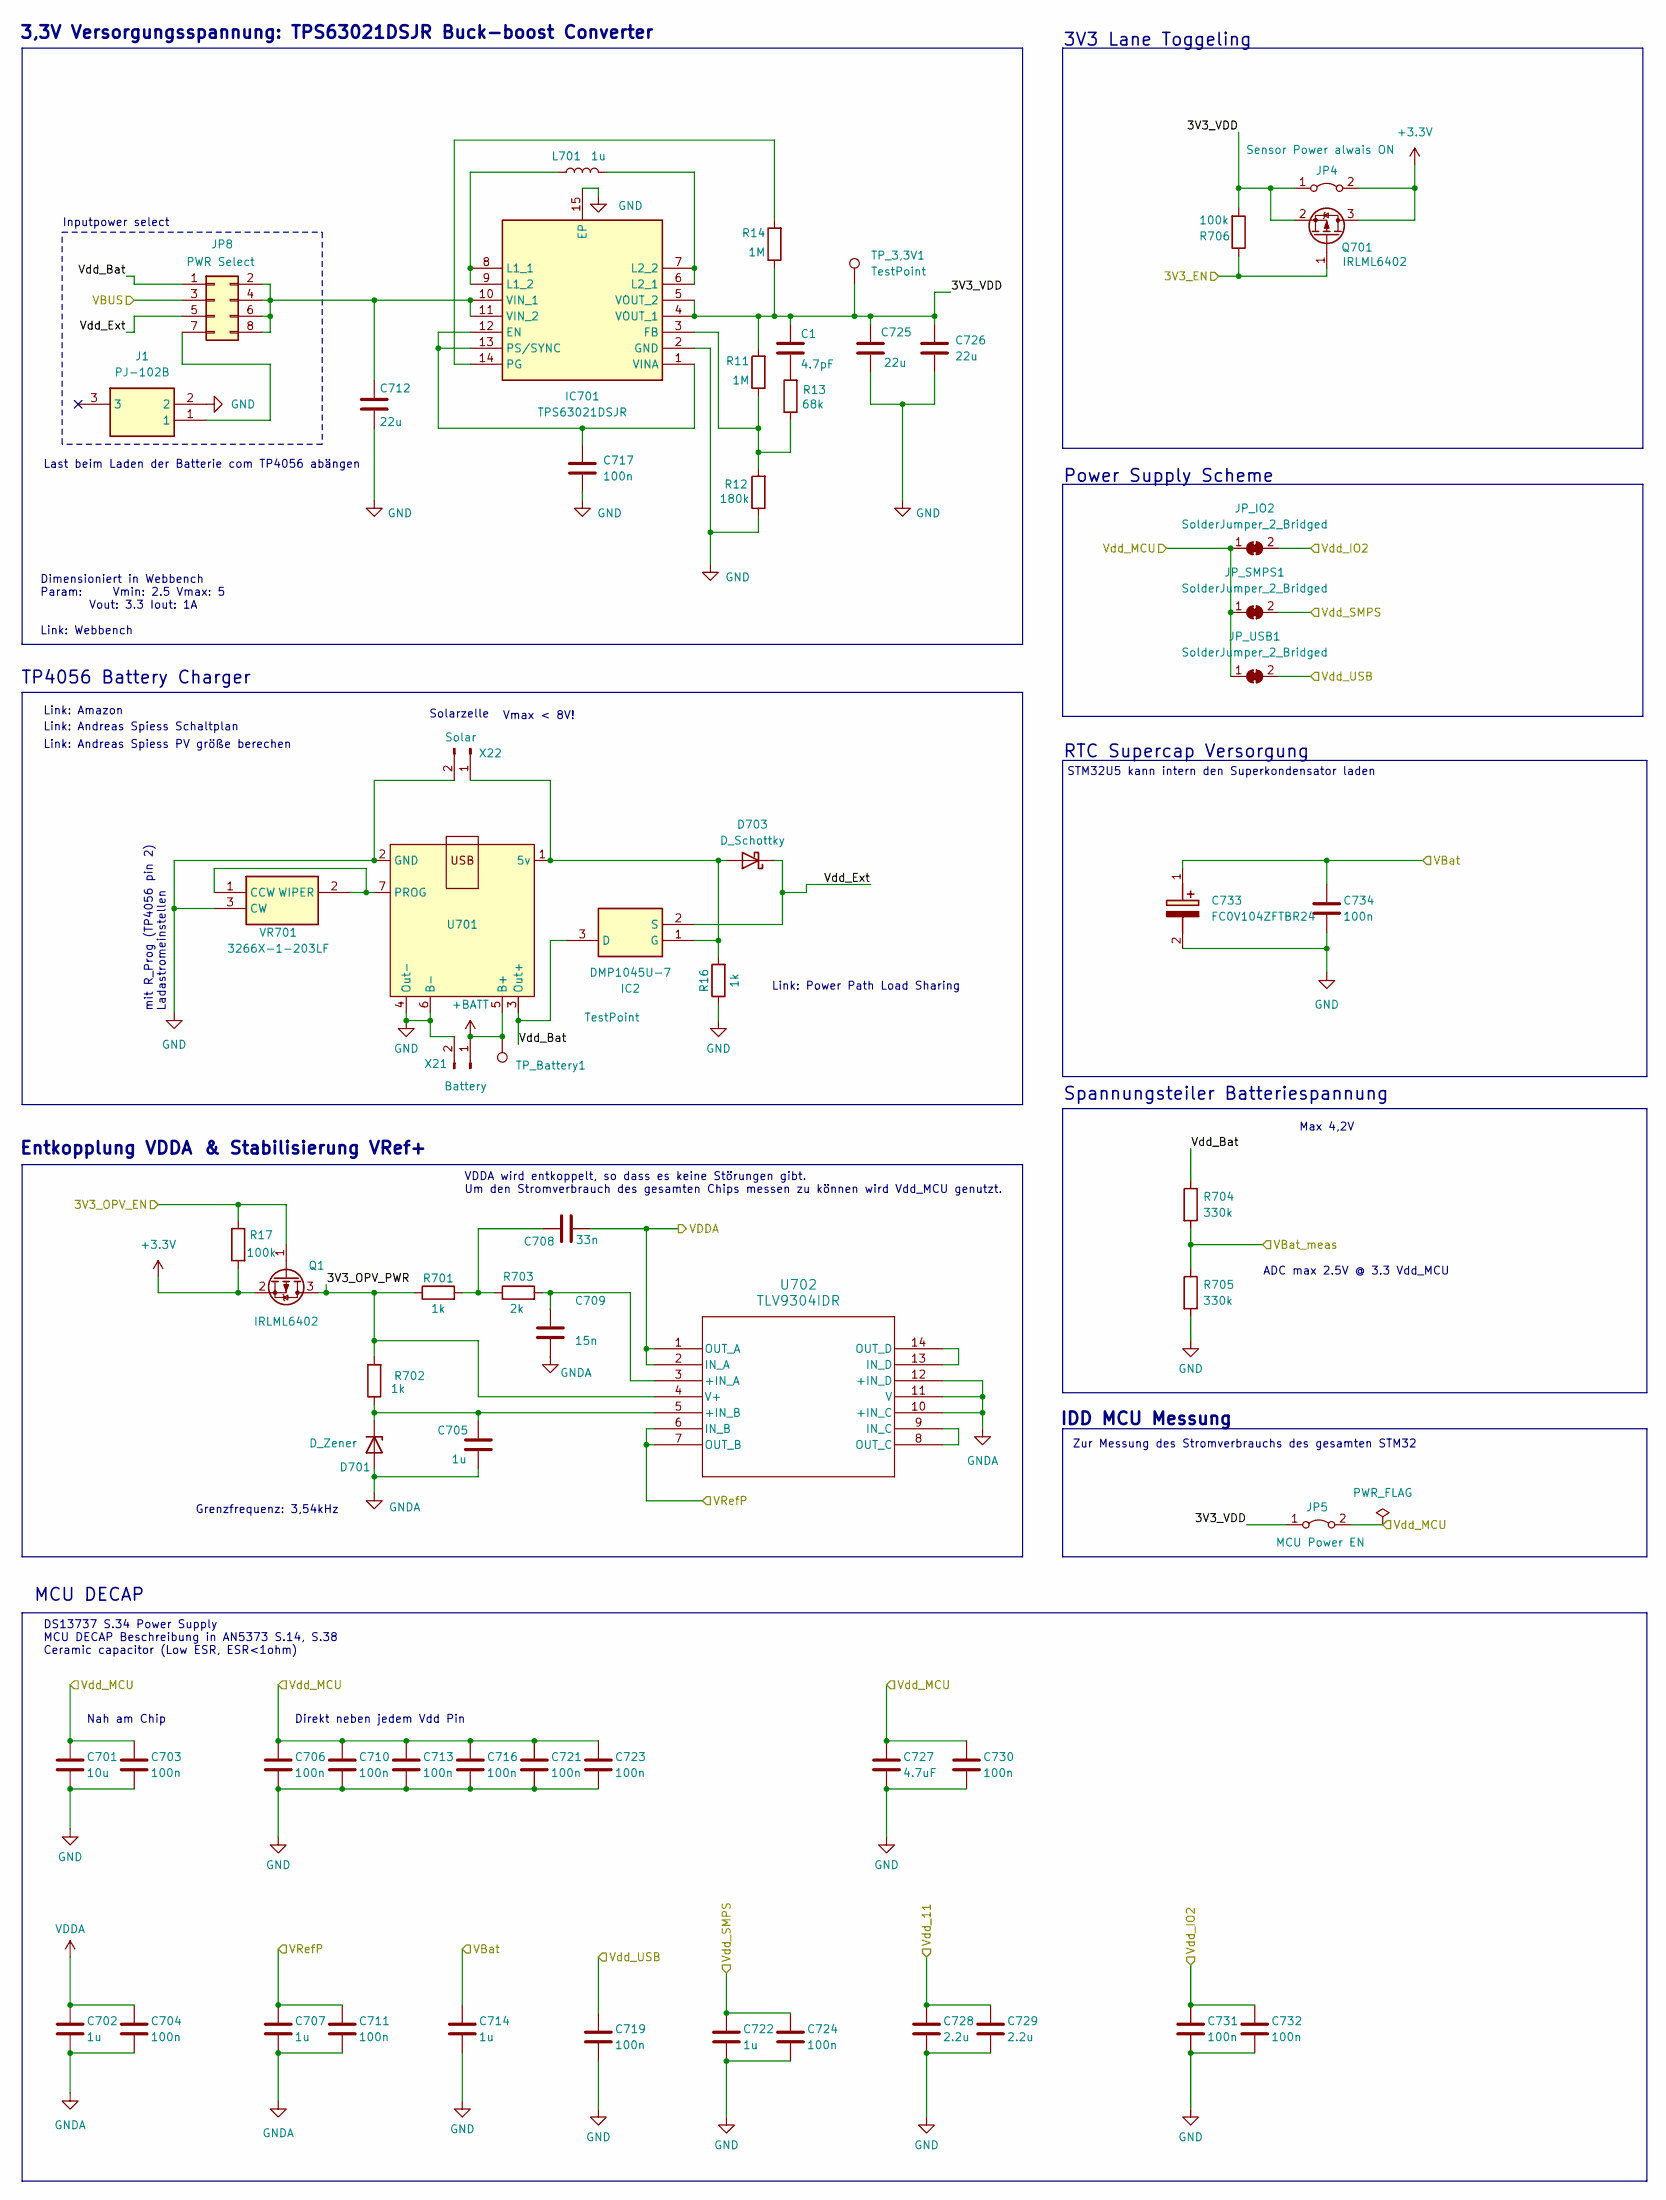
[picture p37: schematic Power.kicad_sch, Power Supply]

Parts:
C1: 4.7pF; C_0805_2012Metric_Pad1.18x1.45mm_HandSolder; Mouser Part Number 77-VJ0805A4R7DXQPBC
C701: 10u; C_0805_2012Metric_Pad1.18x1.45mm_HandSolder; Mouser Part Number 187-CL21A106KQFNNNG
C702, C705, C707, C714, C722: 1u; C_0805_2012Metric_Pad1.18x1.45mm_HandSolder; Mouser Part Number 80-C0805C105K3RACTM
C703, C704, C706, C710, C711, C713, C716, C717, C719, C721, C723, C724, C730, C731, C732, C734: 100n; C_0805_2012Metric_Pad1.18x1.45mm_HandSolder; Mouser Part Number 603-CC805KRX7R9BB104
C708: 33n; C_0805_2012Metric_Pad1.18x1.45mm_HandSolder; Mouser Part Number 710-885012207095
C709: 15n; C_0805_2012Metric_Pad1.18x1.45mm_HandSolder; Mouser Part Number 80-C0805C153K1R
C712, C725, C726: 22u; C_0805_2012Metric_Pad1.18x1.45mm_HandSolder; Mouser Part Number 187-CL21A226KQCLRNC
C727: 4.7uF; C_0805_2012Metric_Pad1.18x1.45mm_HandSolder; Mouser Part Number 187-CL21A475KAQNNNE
C728, C729: 2.2u; C_0805_2012Metric_Pad1.18x1.45mm_HandSolder; Mouser Part Number 187-CL21B225KPFNNNE
C733: FC0V104ZFTBR24; CAPAE1080X550N; Mouser Part Number 80-FC0V104ZFTBR24
D701: D_Zener; D_SOD-123; Mouser Part Number 863-MMSZ5222BT1G
D703: D_Schottky; D_SOD-123F; Mouser Part Number 621-MBR230S1F-7
IC2: DMP1045U-7; SOT50P160X90-3N; Mouser Part Number 621-DMP1045U-7
IC701: TPS63021DSJR; SON50P300X400X100-15N-D; Mouser Part Number 595-TPS63021DSJR
J1: PJ-102B; BarrelJack_CUI_PJ-102AH_Horizontal; Manufacturer_Part_Number PJ-102B; Mouser Part Number 490-PJ-102B
JP4, JP5: Jumper_2_Bridged; PinHeader_1x02_P2.54mm_Vertical; Mouser Part Number 523-G800NA306018EU
JP8: Conn_02x04_Odd_Even; PinHeader_2x04_P2.54mm_Vertical; Mouser Part Number 649-1012938190403BLF
JP_IO2: SolderJumper_2_Bridged; SolderJumper-2_P1.3mm_Open_RoundedPad1.0x1.5mm
JP_SMPS1: SolderJumper_2_Bridged; SolderJumper-2_P1.3mm_Open_RoundedPad1.0x1.5mm
JP_USB1: SolderJumper_2_Bridged; SolderJumper-2_P1.3mm_Open_RoundedPad1.0x1.5mm
L701: 1u; L_0805_2012Metric_Pad1.15x1.40mm_HandSolder; Mouser Part Number 80-C0805C105K3RACTM
Q1, Q701: IRLML6402; SOT-23; Mouser Part Number 942-IRLML6402TRPBF
R11, R14: 1M; R_0805_2012Metric_Pad1.20x1.40mm_HandSolder; Mouser Part Number 603-RV0805JR-071ML
R12: 180k; R_0805_2012Metric_Pad1.20x1.40mm_HandSolder; Mouser Part Number 652-CR0805JW-184ELF
R13: 68k; R_0805_2012Metric_Pad1.20x1.40mm_HandSolder; Mouser Part Number 660-RK73B2ATTD683J
R16, R701, R702: 1k; R_0805_2012Metric_Pad1.20x1.40mm_HandSolder; Mouser Part Number 667-ERJ-6ENF1001V
R17, R706: 100k; R_0805_2012Metric_Pad1.20x1.40mm_HandSolder; Mouser Part Number 660-RK73B2ATTE104J
R703: 2k; R_0805_2012Metric_Pad1.20x1.40mm_HandSolder; Mouser Part Number 279-CRG0805F2K0
R704, R705: 330k; R_0805_2012Metric_Pad1.20x1.40mm_HandSolder; Mouser Part Number 652-CR0805AFX3303EAS
TP_3,3V1: TestPoint; TestPoint_Pad_1.5x1.5mm
TP_Battery1: TestPoint; TestPoint_Pad_1.5x1.5mm
U701: TP4056-18650-2
U702: TLV9304IDR; SOIC127P600X175-14N; Mouser Part Number 595-TLV9304IDR
VR701: 3266X-1-203LF; 3266X1203LF; Mouser Part Number 652-3266X-1-203LF
X21, X22: Conn_01x02_Pin; JST_XH_B2B-XH-AM_1x02_P2.50mm_Vertical; Mouser Part Number 474-PRT-09914

Connections:
+3.3V: JP4.2 (B), Q1.2 (S), Q701.3 (D), R17.2; also elsewhere on the board
+BATT: TP_Battery1.1, U701.5 (B+), X21.1
/IO and mounting holes/VBUS: JP8.3; also elsewhere on the board
/Power Supply/3V3_EN: Q701.1 (G), R706.1; also elsewhere on the board
/Power Supply/3V3_OPV_EN: Q1.1 (G), R17.1; also elsewhere on the board
/Power Supply/3V3_OPV_PWR: Q1.3 (D), R701.1, R702.2, U702.4 (V+)
/Power Supply/3V3_VDD: C1.1, C725.1, C726.1, IC701.4 (VOUT_1), IC701.5 (VOUT_2), JP4.1 (A), JP5.1 (A), Q701.2 (S), R11.2, R14.1, R706.2, TP_3,3V1.1
/Power Supply/VBat: C714.1, C733.1 (+), C734.1; also elsewhere on the board
/Power Supply/VBat_meas: R704.2, R705.1; also elsewhere on the board
/Power Supply/VRefP: C707.1, C711.1, U702.6 (IN_B), U702.7 (OUT_B); also elsewhere on the board
/Power Supply/Vdd_Bat: IC2.3 (D), JP8.1, R704.1, U701.3 (Out+)
/Power Supply/Vdd_Ext: D703.1 (K), IC2.2 (S), JP8.5
/Power Supply/Vdd_IO2: C731.1, C732.1, JP_IO2.2 (B); also elsewhere on the board
/Power Supply/Vdd_MCU: C701.1, C703.1, C706.1, C710.1, C713.1, C716.1, C721.1, C723.1, C727.1, C730.1, JP5.2 (B), JP_IO2.1 (A), JP_SMPS1.1 (A), JP_USB1.1 (A); also elsewhere on the board
/Power Supply/Vdd_SMPS: C722.1, C724.1, JP_SMPS1.2 (B); also elsewhere on the board
/Power Supply/Vdd_USB: C719.1, JP_USB1.2 (B); also elsewhere on the board
/STM32U575ZIT6Q/Vdd_11: C728.1, C729.1; also elsewhere on the board
GND: C701.2, C703.2, C706.2, C710.2, C712.2, C713.2, C714.2, C716.2, C717.2, C719.2, C721.2, C722.2, C723.2, C724.2, C725.2, C726.2, C727.2, C728.2, C729.2, C730.2, C731.2, C732.2, C733.2 (-), C734.2, IC701.2 (GND), IC701.15 (EP), J1.2, R12.1, R16.1, R705.2, U701.2 (GND), U701.4 (Out-), U701.6 (B-), VR701.3 (CW), X21.2, X22.2; also elsewhere on the board
GNDA: C702.2, C704.2, C705.2, C707.2, C709.2, C711.2, D701.2 (A), U702.10 (+IN_C), U702.11 (V), U702.12 (+IN_D); also elsewhere on the board
unnamed: C1.2, R13.2
unnamed: C708.1, R701.2, R703.1
unnamed: C705.1, D701.1 (K), R702.1, U702.5 (+IN_B)
unnamed: D703.2 (A), IC2.1 (G), R16.2, U701.1 (5v), X22.1
unnamed: C717.1, IC701.1 (VINA), IC701.12 (EN), IC701.13 (PS/SYNC)
unnamed: IC701.3 (FB), R11.1, R12.2, R13.1
unnamed: IC701.8 (L1_1), IC701.9 (L1_2), L701.1
unnamed: IC701.6 (L2_1), IC701.7 (L2_2), L701.2
unnamed: IC701.14 (PG), R14.2
unnamed: C712.1, IC701.10 (VIN_1), IC701.11 (VIN_2), JP8.2, JP8.4, JP8.6, JP8.8
unnamed: J1.1, JP8.7
unnamed: U701.7 (PROG), VR701.1 (CCW), VR701.2 (WIPER)
unnamed: C709.1, R703.2, U702.3 (+IN_A)
unnamed: U702.8 (OUT_C), U702.9 (IN_C)
unnamed: U702.13 (IN_D), U702.14 (OUT_D)
VDDA: C702.1, C704.1, C708.2, U702.1 (OUT_A), U702.2 (IN_A); also elsewhere on the board

Notes on the sheet:
IDD MCU Messung
Grenzfrequenz: 3,54kHz
3V3 Lane Toggeling
Vmax < 8V!
& Stabilisierung VRef+
Max 4,2V
Spannungsteiler Batteriespannung
Link: Power Path Load Sharing
VDDA wird entkoppelt, so dass es keine Störungen gibt. Um den Stromverbrauch des gesamten Chips messen zu können wird Vdd_MCU genutzt.
TP4056 Battery Charger
STM32U5 kann intern den Superkondensator laden
Zur Messung des Stromverbrauchs des gesamten STM32
MCU DECAP
Power Supply Scheme
ADC max 2.5V @ 3.3 Vdd_MCU
Link: Amazon
RTC Supercap Versorgung
Entkopplung VDDA
mit R_Prog (TP4056 pin 2) Ladastromeinstellen
DS13737 S.34 Power Supply MCU DECAP Beschreibung in AN5373 S.14, S.38 Ceramic capacitor (Low ESR, ESR<1ohm)
3,3V Versorgungsspannung: TPS63021DSJR Buck-boost Converter
Link: Andreas Spiess Schaltplan
Last beim Laden der Batterie com TP4056 abängen
Dimensioniert in Webbench Param: Vmin: 2.5 Vmax: 5 Vout: 3.3 Iout: 1A
Nah am Chip
Solarzelle
Inputpower select
Link: Andreas Spiess PV größe berechen
Link: Webbench
Direkt neben jedem Vdd Pin

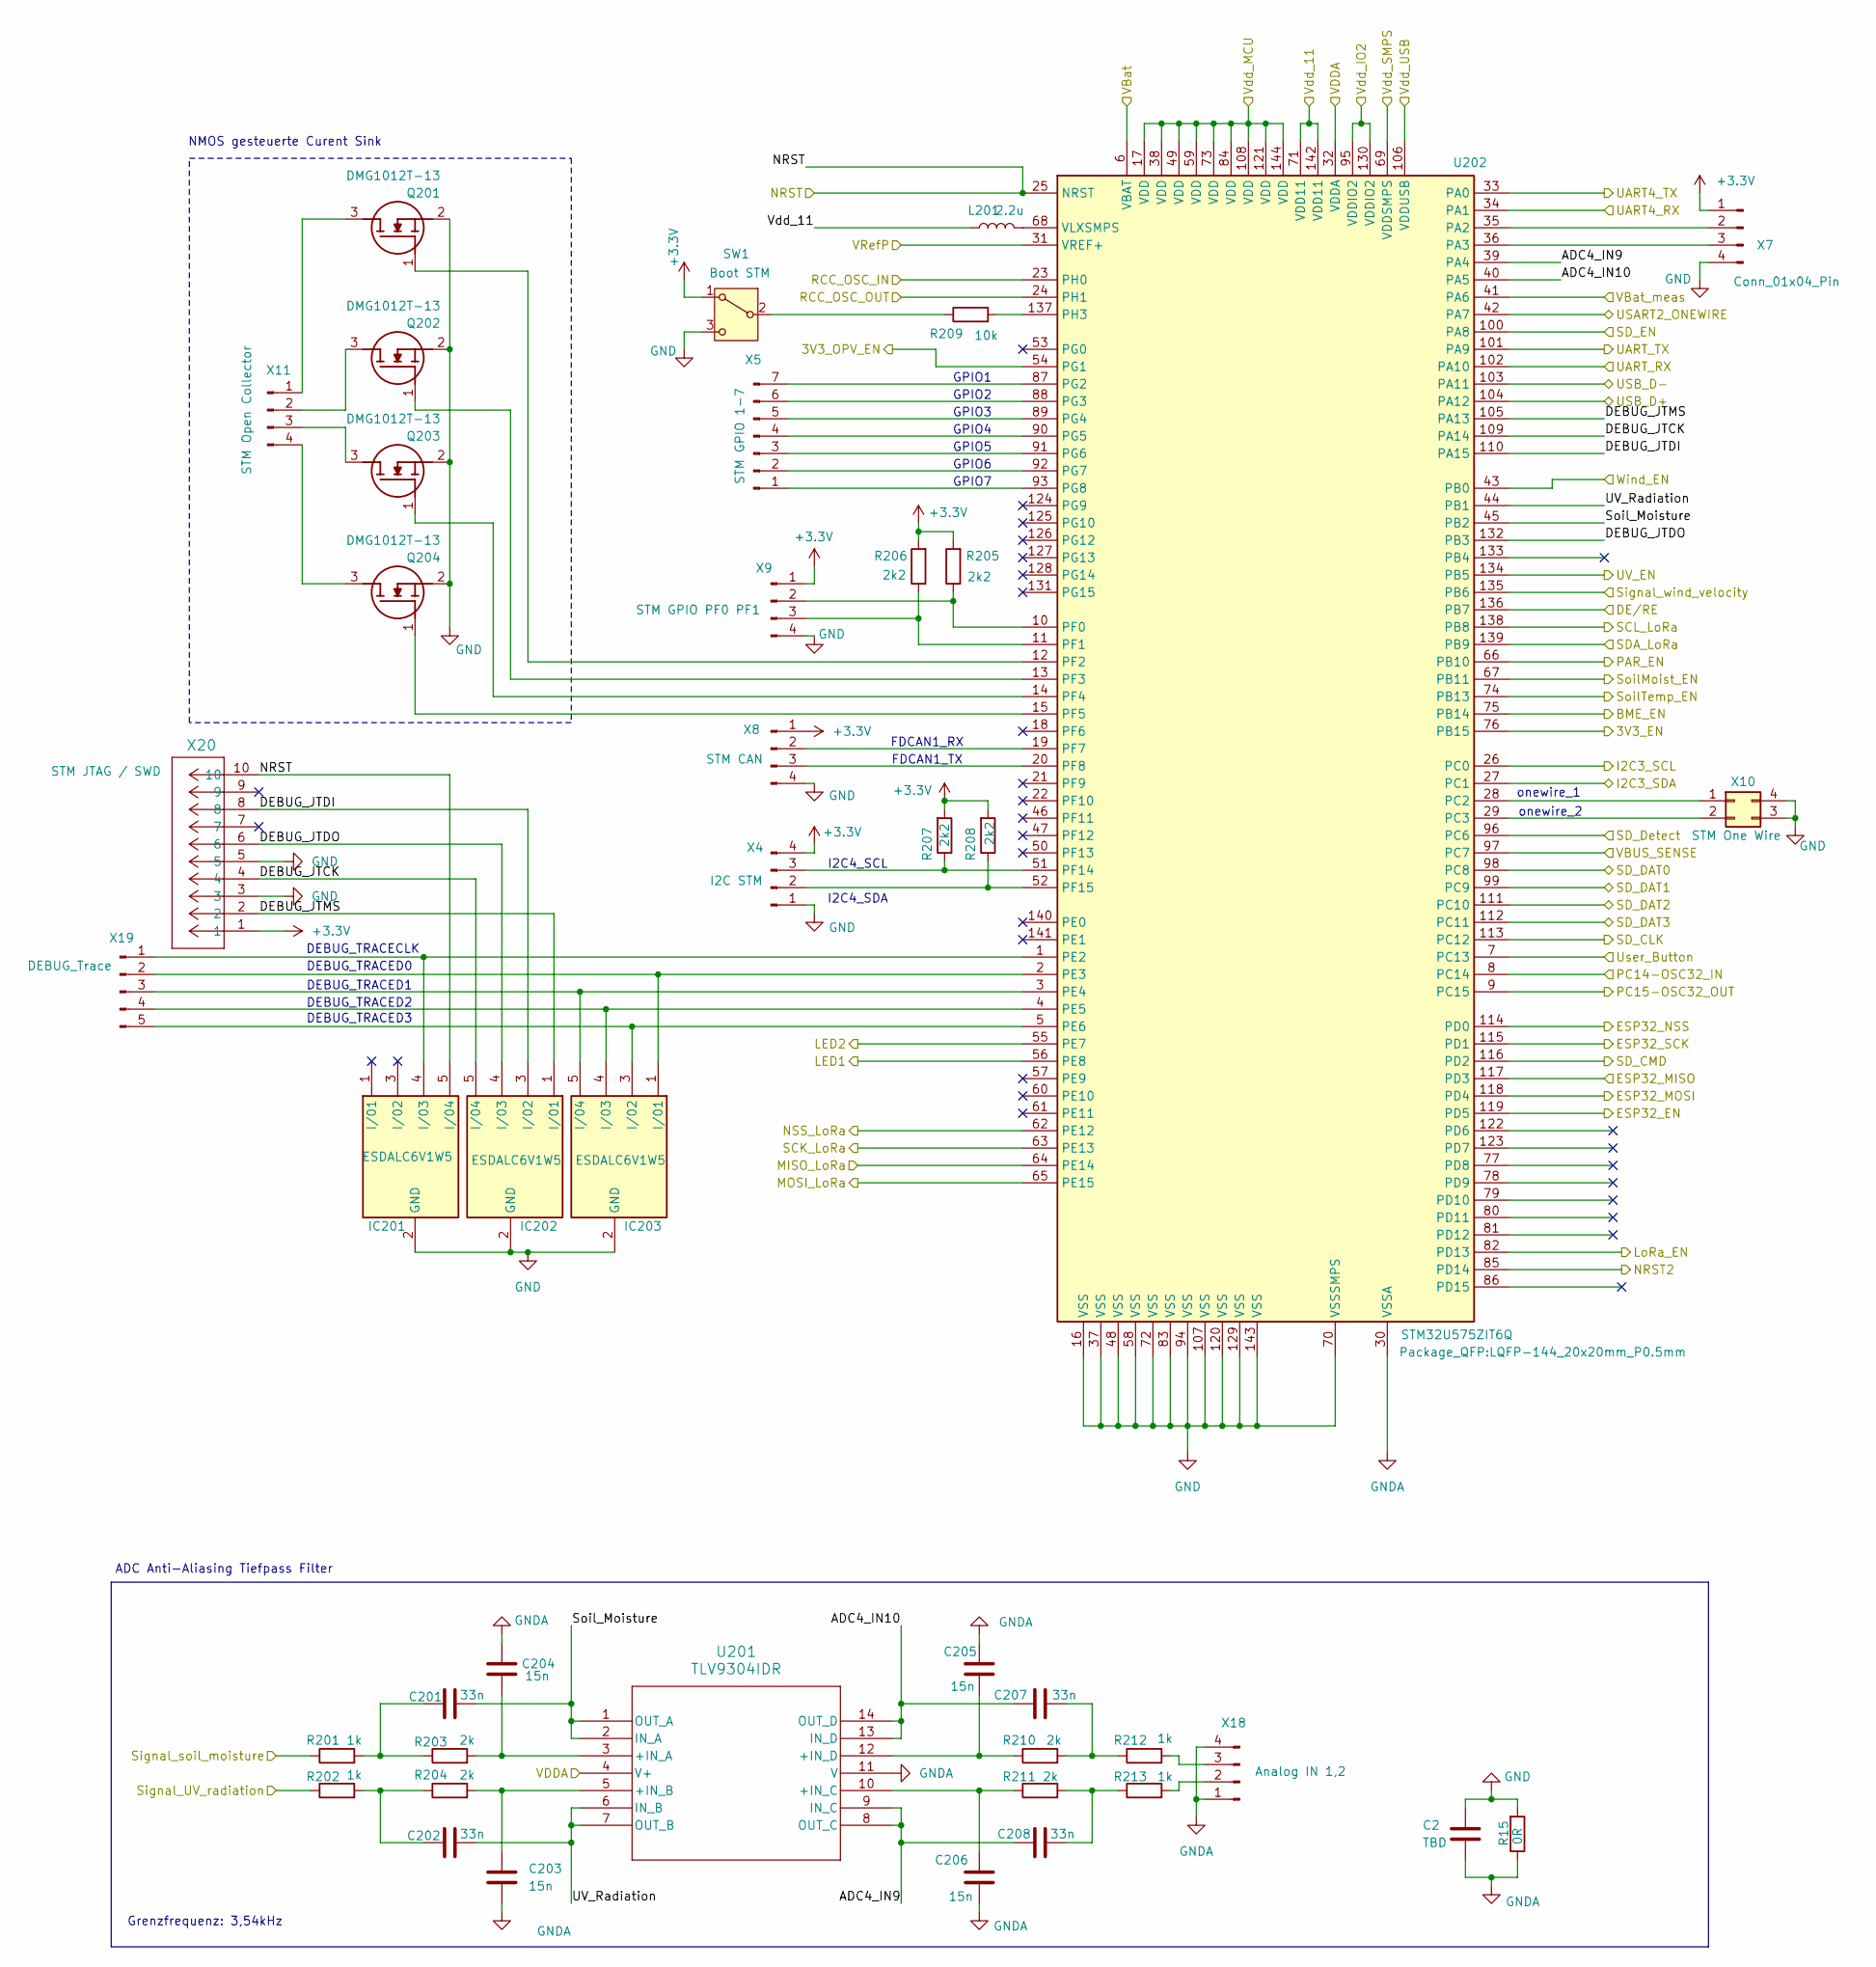
[picture p38: schematic STM32.kicad_sch, µC Agri-PV]

Parts:
C2: TBD; C_0805_2012Metric_Pad1.18x1.45mm_HandSolder
C201, C202, C207, C208: 33n; C_0805_2012Metric_Pad1.18x1.45mm_HandSolder; Mouser Part Number 710-885012207095
C203, C204, C205, C206: 15n; C_0805_2012Metric_Pad1.18x1.45mm_HandSolder; Mouser Part Number 80-C0805C153K1R
IC201, IC202, IC203: ESDALC6V1W5; SOT65P210X110-5N; Mouser Part Number 511-ESDALC6V1W5
L201: 2.2u; L_1210_3225Metric_Pad1.42x2.65mm_HandSolder; Mouser Part Number 810-TMS322512ALM2R2M
Q201, Q202, Q203, Q204: DMG1012T-13; SOT50P160X90-3N; Mouser Part Number 621-DMG1012T-13
R15: 0R; R_0805_2012Metric_Pad1.20x1.40mm_HandSolder; Mouser Part Number 279-CRG0805ZR
R201, R202, R212, R213: 1k; R_0805_2012Metric_Pad1.20x1.40mm_HandSolder; Mouser Part Number 667-ERJ-6ENF1001V
R203, R204, R210, R211: 2k; R_0805_2012Metric_Pad1.20x1.40mm_HandSolder; Mouser Part Number 279-CRG0805F2K0
R205, R206, R207, R208: 2k2; R_0805_2012Metric_Pad1.20x1.40mm_HandSolder; Mouser Part Number 756-WCR0805-2K2FI
R209: 10k; R_0805_2012Metric_Pad1.20x1.40mm_HandSolder; Mouser Part Number 660-RK73B2ATTD103G
SW1: SW_SPDT; SW_JS102011JCQN; Mouser Part Number 611-JS102011JCBN
U201: TLV9304IDR; SOIC127P600X175-14N; Mouser Part Number 595-TLV9304IDR
U202: STM32U575ZIT6Q; LQFP-144_20x20mm_P0.5mm; Mouser Part Number 511-STM32U575ZIT6Q
X4, X7, X8, X9, X11: Conn_01x04_Pin; PinHeader_1x04_P2.54mm_Vertical; Mouser Part Number 523-G800LW304032EU
X5: Conn_01x07_Pin; PinHeader_1x07_P2.54mm_Vertical; Mouser Part Number 855-M20-9770746
X10: Conn_02x02_Counter_Clockwise; PinHeader_2x02_P2.54mm_Vertical; Mouser Part Number 649-67997-100HLF
X18: Conn_01x04_Pin; JST_XH_B4B-XH-AM_1x04_P2.50mm_Vertical; Mouser Part Number 306-B4BXHAMLFSNP
X19: Conn_01x05_Pin; PinHeader_1x05_P2.54mm_Vertical; Mouser Part Number 523-G800W303018EU
X20: 3220-10-0100-00; CONN_3220-10-0100-00_CNC

Connections:
+3.3V: R205.2, R206.2, R207.2, R208.2, SW1.1 (A), X4.4, X7.1, X8.1, X9.1, X20.1; also elsewhere on the board
/ESP32-C6-WROOM-1-N8/ESP32_EN: U202.119 (PD5); also elsewhere on the board
/ESP32-C6-WROOM-1-N8/ESP32_MISO: U202.117 (PD3); also elsewhere on the board
/ESP32-C6-WROOM-1-N8/ESP32_MOSI: U202.118 (PD4); also elsewhere on the board
/ESP32-C6-WROOM-1-N8/ESP32_NSS: U202.114 (PD0); also elsewhere on the board
/ESP32-C6-WROOM-1-N8/ESP32_SCK: U202.115 (PD1); also elsewhere on the board
/IO and mounting holes/LED1: U202.56 (PE8); also elsewhere on the board
/IO and mounting holes/LED2: U202.55 (PE7); also elsewhere on the board
/IO and mounting holes/PC14-OSC32_IN: U202.8 (PC14); also elsewhere on the board
/IO and mounting holes/PC15-OSC32_OUT: U202.9 (PC15); also elsewhere on the board
/IO and mounting holes/PH0-OSC_IN: U202.23 (PH0); also elsewhere on the board
/IO and mounting holes/PH1-OSC_OUT: U202.24 (PH1); also elsewhere on the board
/IO and mounting holes/USB_D+: U202.104 (PA12); also elsewhere on the board
/IO and mounting holes/USB_D-: U202.103 (PA11); also elsewhere on the board
/IO and mounting holes/User_Button: U202.7 (PC13); also elsewhere on the board
/IO and mounting holes/VBUS_SENSE: U202.97 (PC7); also elsewhere on the board
/LoRa-E5/LoRa_EN: U202.82 (PD13); also elsewhere on the board
/LoRa-E5/MISO_LoRa: U202.64 (PE14); also elsewhere on the board
/LoRa-E5/MOSI_LoRa: U202.65 (PE15); also elsewhere on the board
/LoRa-E5/NRST2: U202.85 (PD14); also elsewhere on the board
/LoRa-E5/NSS_LoRa: U202.62 (PE12); also elsewhere on the board
/LoRa-E5/SCK_LoRa: U202.63 (PE13); also elsewhere on the board
/LoRa-E5/SCL_LoRa: U202.138 (PB8); also elsewhere on the board
/LoRa-E5/SDA_LoRa: U202.139 (PB9); also elsewhere on the board
/LoRa-E5/UART_RX: U202.102 (PA10); also elsewhere on the board
/LoRa-E5/UART_TX: U202.101 (PA9); also elsewhere on the board
/Micro SD-Card Reader 503398-1892/SD_CLK: U202.113 (PC12); also elsewhere on the board
/Micro SD-Card Reader 503398-1892/SD_CMD: U202.116 (PD2); also elsewhere on the board
/Micro SD-Card Reader 503398-1892/SD_DAT0: U202.98 (PC8); also elsewhere on the board
/Micro SD-Card Reader 503398-1892/SD_DAT1: U202.99 (PC9); also elsewhere on the board
/Micro SD-Card Reader 503398-1892/SD_DAT2: U202.111 (PC10); also elsewhere on the board
/Micro SD-Card Reader 503398-1892/SD_DAT3: U202.112 (PC11); also elsewhere on the board
/Micro SD-Card Reader 503398-1892/SD_Detect: U202.96 (PC6); also elsewhere on the board
/Micro SD-Card Reader 503398-1892/SD_EN: U202.100 (PA8); also elsewhere on the board
/Power Supply/3V3_EN: U202.76 (PB15); also elsewhere on the board
/Power Supply/3V3_OPV_EN: U202.54 (PG1); also elsewhere on the board
/Power Supply/VBat: U202.6 (VBAT); also elsewhere on the board
/Power Supply/VBat_meas: U202.41 (PA6); also elsewhere on the board
/Power Supply/VRefP: U202.31 (VREF+); also elsewhere on the board
/Power Supply/Vdd_IO2: U202.95 (VDDIO2), U202.130 (VDDIO2); also elsewhere on the board
/Power Supply/Vdd_MCU: U202.17 (VDD), U202.38 (VDD), U202.49 (VDD), U202.59 (VDD), U202.73 (VDD), U202.84 (VDD), U202.108 (VDD), U202.121 (VDD), U202.144 (VDD); also elsewhere on the board
/Power Supply/Vdd_SMPS: U202.69 (VDDSMPS); also elsewhere on the board
/Power Supply/Vdd_USB: U202.106 (VDDUSB); also elsewhere on the board
/STM32U575ZIT6Q/ADC4_IN9: C208.2, U201.8 (OUT_C), U201.9 (IN_C), U202.39 (PA4)
/STM32U575ZIT6Q/ADC4_IN10: C207.2, U201.13 (IN_D), U201.14 (OUT_D), U202.40 (PA5)
/STM32U575ZIT6Q/BME_EN: U202.75 (PB14); also elsewhere on the board
/STM32U575ZIT6Q/DEBUG_JTCK: IC202.5 (I/04), U202.109 (PA14), X20.4
/STM32U575ZIT6Q/DEBUG_JTDI: IC202.3 (I/02), U202.110 (PA15), X20.8
/STM32U575ZIT6Q/DEBUG_JTDO: IC202.4 (I/03), U202.132 (PB3), X20.6
/STM32U575ZIT6Q/DEBUG_JTMS: IC202.1 (I/01), U202.105 (PA13), X20.2
/STM32U575ZIT6Q/DE/RE: U202.136 (PB7); also elsewhere on the board
/STM32U575ZIT6Q/I2C3_SCL: U202.26 (PC0); also elsewhere on the board
/STM32U575ZIT6Q/I2C3_SDA: U202.27 (PC1); also elsewhere on the board
/STM32U575ZIT6Q/NRST: IC201.5 (I/04), U202.25 (NRST), X20.10; also elsewhere on the board
/STM32U575ZIT6Q/PAR_EN: U202.66 (PB10); also elsewhere on the board
/STM32U575ZIT6Q/Signal_UV_radiation: R202.1; also elsewhere on the board
/STM32U575ZIT6Q/Signal_soil_moisture: R201.1; also elsewhere on the board
/STM32U575ZIT6Q/Signal_wind_velocity: U202.135 (PB6); also elsewhere on the board
/STM32U575ZIT6Q/SoilMoist_EN: U202.67 (PB11); also elsewhere on the board
/STM32U575ZIT6Q/SoilTemp_EN: U202.74 (PB13); also elsewhere on the board
/STM32U575ZIT6Q/Soil_Moisture: C201.1, U201.1 (OUT_A), U201.2 (IN_A), U202.45 (PB2)
/STM32U575ZIT6Q/UART4_RX: U202.34 (PA1); also elsewhere on the board
/STM32U575ZIT6Q/UART4_TX: U202.33 (PA0); also elsewhere on the board
/STM32U575ZIT6Q/USART2_ONEWIRE: U202.42 (PA7); also elsewhere on the board
/STM32U575ZIT6Q/UV_EN: U202.134 (PB5); also elsewhere on the board
/STM32U575ZIT6Q/UV_Radiation: C202.1, U201.6 (IN_B), U201.7 (OUT_B), U202.44 (PB1)
/STM32U575ZIT6Q/Vdd_11: L201.1, U202.71 (VDD11), U202.142 (VDD11); also elsewhere on the board
/STM32U575ZIT6Q/Wind_EN: U202.43 (PB0); also elsewhere on the board
GND: C2.2, IC201.2 (GND), IC202.2 (GND), IC203.2 (GND), Q201.2 (S), Q202.2 (S), Q203.2 (S), Q204.2 (S), R15.2, SW1.3 (C), U202.16 (VSS), U202.37 (VSS), U202.48 (VSS), U202.58 (VSS), U202.70 (VSSSMPS), U202.72 (VSS), U202.83 (VSS), U202.94 (VSS), U202.107 (VSS), U202.120 (VSS), U202.129 (VSS), U202.143 (VSS), X4.1, X7.4, X8.4, X9.4, X10.3, X10.4, X20.3, X20.5; also elsewhere on the board
GNDA: C2.1, C203.2, C204.1, C205.1, C206.2, R15.1, U201.11 (V), U202.30 (VSSA), X18.1, X18.4; also elsewhere on the board
unnamed: C201.2, R201.2, R203.1
unnamed: C202.2, R202.2, R204.1
unnamed: C207.1, R210.2, R212.1
unnamed: C208.1, R211.2, R213.1
unnamed: IC201.4 (I/03), U202.1 (PE2), X19.1
unnamed: IC203.1 (I/01), U202.2 (PE3), X19.2
unnamed: IC203.3 (I/02), U202.5 (PE6), X19.5
unnamed: IC203.4 (I/03), U202.4 (PE5), X19.4
unnamed: IC203.5 (I/04), U202.3 (PE4), X19.3
unnamed: Q201.3 (D), X11.1
unnamed: Q201.1 (G), U202.12 (PF2)
unnamed: Q202.3 (D), X11.2
unnamed: Q202.1 (G), U202.13 (PF3)
unnamed: Q203.3 (D), X11.3
unnamed: Q203.1 (G), U202.14 (PF4)
unnamed: Q204.3 (D), X11.4
unnamed: Q204.1 (G), U202.15 (PF5)
unnamed: R209.1, SW1.2 (B)
unnamed: C204.2, R203.2, U201.3 (+IN_A)
unnamed: C203.1, R204.2, U201.5 (+IN_B)
unnamed: C206.1, R211.1, U201.10 (+IN_C)
unnamed: C205.2, R210.1, U201.12 (+IN_D)
unnamed: U202.35 (PA2), X7.2
unnamed: U202.36 (PA3), X7.3
unnamed: U202.28 (PC2), X10.1
unnamed: U202.29 (PC3), X10.2
unnamed: R205.1, U202.10 (PF0), X9.2
unnamed: R206.1, U202.11 (PF1), X9.3
unnamed: U202.19 (PF7), X8.2
unnamed: U202.20 (PF8), X8.3
unnamed: R207.1, U202.51 (PF14), X4.3
unnamed: R208.1, U202.52 (PF15), X4.2
unnamed: U202.87 (PG2), X5.7
unnamed: U202.88 (PG3), X5.6
unnamed: U202.89 (PG4), X5.5
unnamed: U202.90 (PG5), X5.4
unnamed: U202.91 (PG6), X5.3
unnamed: U202.92 (PG7), X5.2
unnamed: U202.93 (PG8), X5.1
unnamed: R209.2, U202.137 (PH3)
unnamed: L201.2, U202.68 (VLXSMPS)
unnamed: R213.2, X18.2
unnamed: R212.2, X18.3
VDDA: U201.4 (V+), U202.32 (VDDA); also elsewhere on the board

Notes on the sheet:
onewire_2
DEBUG_TRACED0
FDCAN1_RX
GPIO6
NMOS gesteuerte Curent Sink
I2C4_SCL
DEBUG_TRACED2
GPIO3
GPIO2
I2C4_SDA
GPIO7
DEBUG_TRACED3
GPIO1
Grenzfrequenz: 3,54kHz
GPIO4
DEBUG_TRACED1
ADC Anti-Aliasing Tiefpass Filter
DEBUG_TRACECLK
FDCAN1_TX
GPIO5
onewire_1

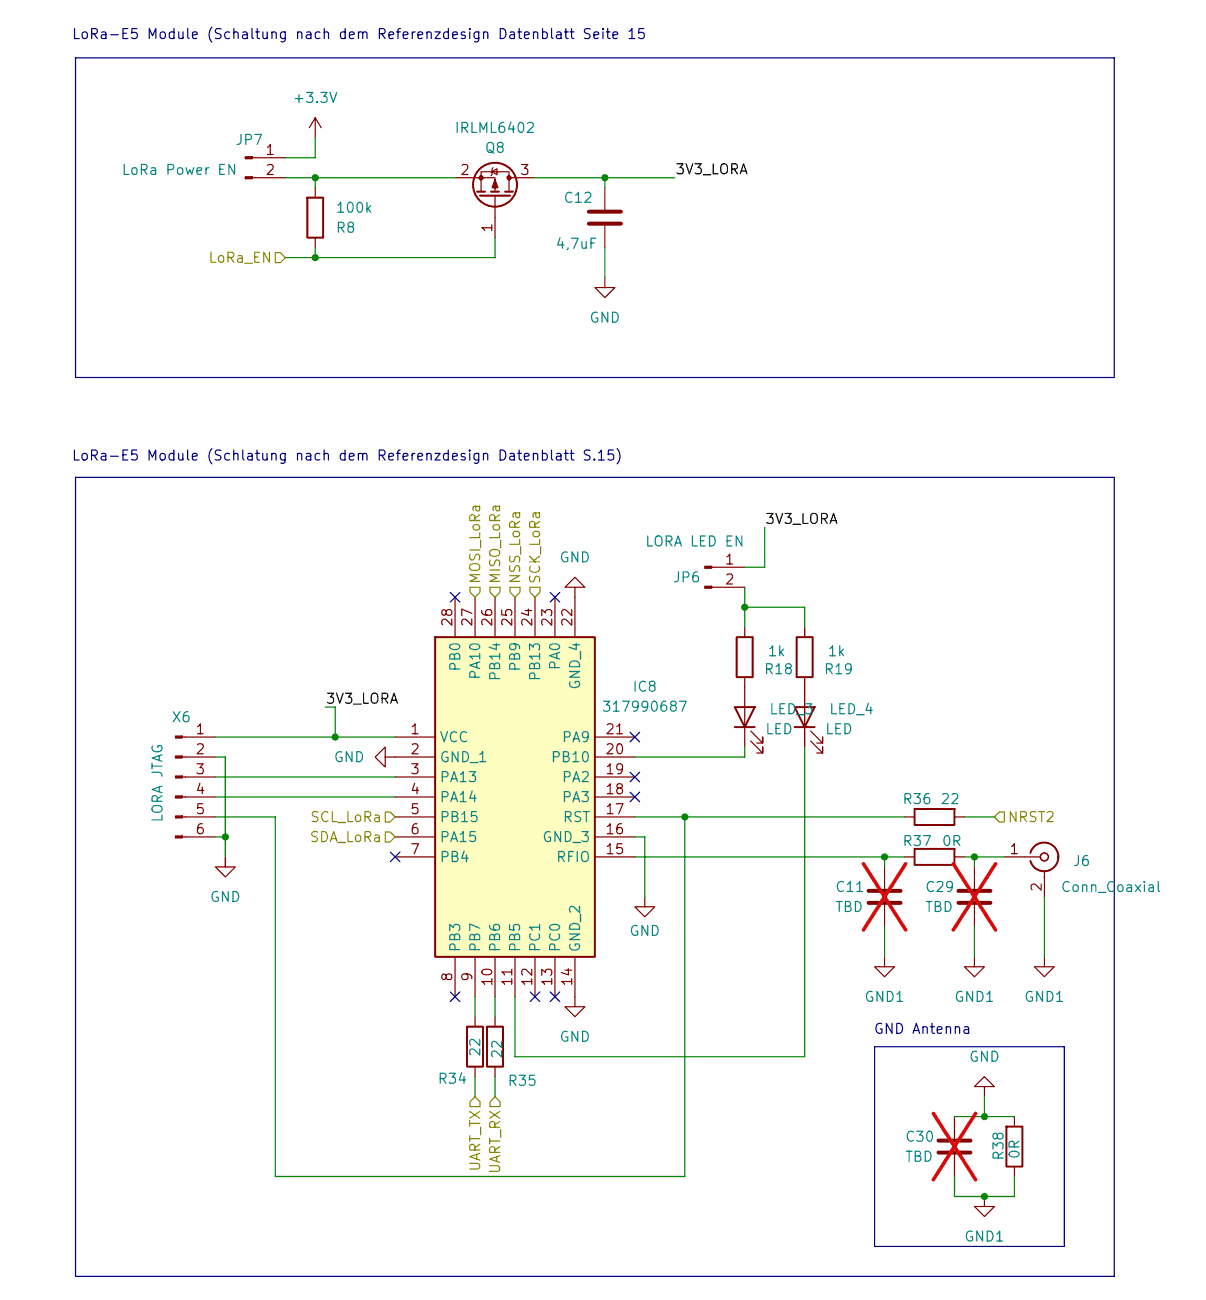
[picture p39: schematic LoRa.kicad_sch, LoRa RFM95W-868S2]

Parts:
C11, C29, C30: TBD; C_0805_2012Metric_Pad1.18x1.45mm_HandSolder; not fitted
C12: 4,7uF; C_0805_2012Metric_Pad1.18x1.45mm_HandSolder; Mouser Part Number 187-CL21A226KQCLRNC
IC8: 317990687; QFN_90687_SEE-M; Mouser Part Number 713-317990687
J6: Conn_Coaxial; SMA_Samtec_SMA-J-P-H-ST-EM1_EdgeMount
JP6, JP7: Conn_01x02_Pin; PinHeader_1x02_P2.54mm_Vertical; Mouser Part Number 523-G800NA306018EU
LED_3, LED_4: LED; LED_0805_2012Metric_Pad1.15x1.40mm_HandSolder; Mouser Part Number 630-HSME-C170
Q8: IRLML6402; SOT-23; Mouser Part Number 942-IRLML6402TRPBF
R8: 100k; R_0805_2012Metric_Pad1.20x1.40mm_HandSolder; Mouser Part Number 660-RK73B2ATTE104J
R18, R19: 1k; R_0805_2012Metric_Pad1.20x1.40mm_HandSolder; Mouser Part Number 667-ERJ-6ENF1001V
R34, R35, R36: 22; R_0805_2012Metric_Pad1.20x1.40mm_HandSolder; Mouser Part Number 594-MCU08050C2209FP5
R37, R38: 0R; R_0805_2012Metric_Pad1.20x1.40mm_HandSolder; Mouser Part Number 279-CRG0805ZR
X6: Conn_01x06_Pin; PinHeader_1x06_P2.54mm_Vertical; Mouser Part Number 649-1012937990602BLF

Connections:
+3.3V: JP7.1; also elsewhere on the board
/LoRa-E5/3V3_LORA: C12.2, IC8.1 (VCC), JP6.1, Q8.3 (D), X6.1
/LoRa-E5/LoRa_EN: Q8.1 (G), R8.1; also elsewhere on the board
/LoRa-E5/MISO_LoRa: IC8.26 (PB14); also elsewhere on the board
/LoRa-E5/MOSI_LoRa: IC8.27 (PA10); also elsewhere on the board
/LoRa-E5/NRST2: R36.2; also elsewhere on the board
/LoRa-E5/NSS_LoRa: IC8.25 (PB9); also elsewhere on the board
/LoRa-E5/SCK_LoRa: IC8.24 (PB13); also elsewhere on the board
/LoRa-E5/SCL_LoRa: IC8.5 (PB15); also elsewhere on the board
/LoRa-E5/SDA_LoRa: IC8.6 (PA15); also elsewhere on the board
/LoRa-E5/UART_RX: R35.1; also elsewhere on the board
/LoRa-E5/UART_TX: R34.1; also elsewhere on the board
GND: C12.1, C30.2, IC8.2 (GND_1), IC8.14 (GND_2), IC8.16 (GND_3), IC8.22 (GND_4), R38.2, X6.2, X6.6; also elsewhere on the board
GND1: C11.1, C29.1, C30.1, J6.2 (Ext), R38.1
unnamed: IC8.3 (PA13), X6.3
unnamed: IC8.4 (PA14), X6.4
unnamed: IC8.11 (PB5), LED_4.1 (K)
unnamed: IC8.10 (PB6), R35.2
unnamed: IC8.9 (PB7), R34.2
unnamed: IC8.20 (PB10), LED_3.1 (K)
unnamed: C11.2, IC8.15 (RFIO), R37.1
unnamed: IC8.17 (RST), R36.1, X6.5
unnamed: C29.2, J6.1 (In), R37.2
unnamed: JP6.2, R18.1, R19.1
unnamed: JP7.2, Q8.2 (S), R8.2
unnamed: LED_3.2 (A), R18.2
unnamed: LED_4.2 (A), R19.2

Notes on the sheet:
LoRa-E5 Module (Schlatung nach dem Referenzdesign Datenblatt S.15)
GND Antenna
LoRa-E5 Module (Schaltung nach dem Referenzdesign Datenblatt Seite 15
