DerSchweigefuchs/uC_Agri-PV/uC_Agri-PV.kicad_pcb

## KiCad design uC_Agri-PV.kicad_pcb (continued)

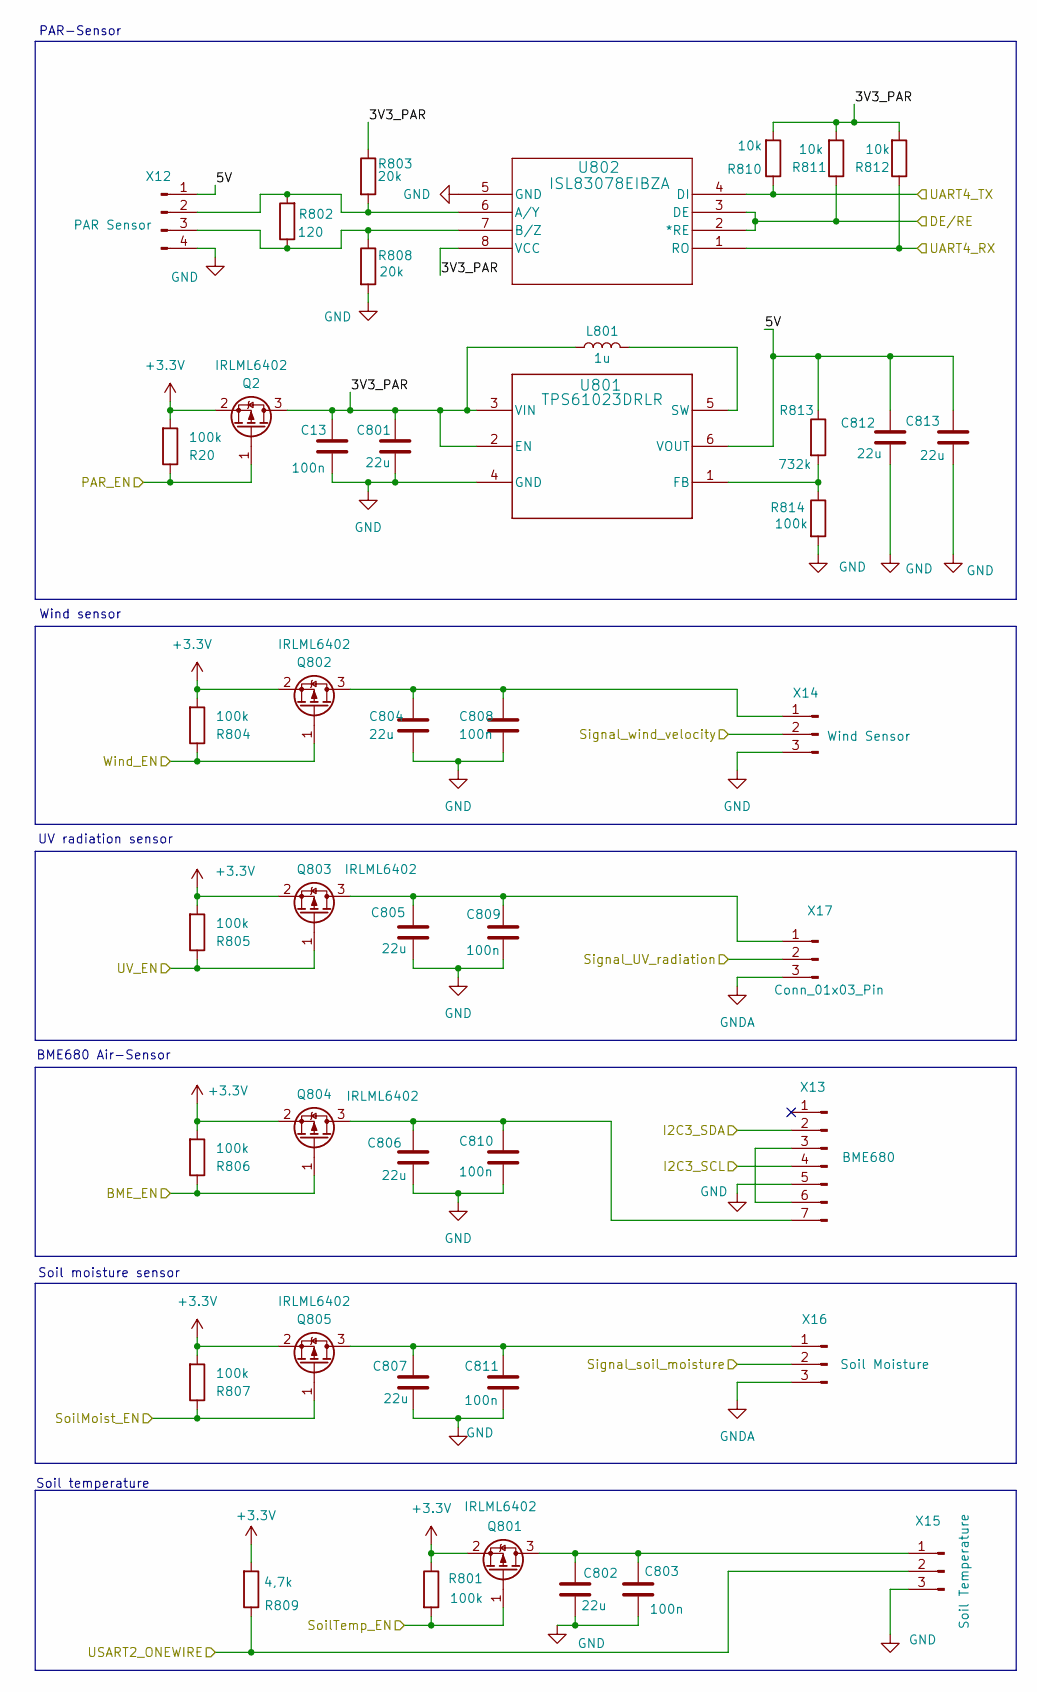
[picture p40: schematic sensors.kicad_sch, Used Sensors]

Parts:
C13, C803, C808, C809, C810, C811: 100n; C_0805_2012Metric_Pad1.18x1.45mm_HandSolder; Mouser Part Number 603-CC805KRX7R9BB104
C801, C802, C804, C805, C806, C807, C812, C813: 22u; C_0805_2012Metric_Pad1.18x1.45mm_HandSolder; Mouser Part Number 187-CL21A226KQCLRNC
L801: 1u; L_0805_2012Metric_Pad1.15x1.40mm_HandSolder; Mouser Part Number 80-C0805C105K3RACTM
Q2, Q801, Q802, Q803, Q804, Q805: IRLML6402; SOT-23; Mouser Part Number 942-IRLML6402TRPBF
R20, R801, R804, R805, R806, R807, R814: 100k; R_0805_2012Metric_Pad1.20x1.40mm_HandSolder; Mouser Part Number 660-RK73B2ATTE104J
R802: 120; R_0805_2012Metric_Pad1.20x1.40mm_HandSolder; Mouser Part Number 652-CR0805JW-121ELF
R803, R808: 20k; R_0805_2012Metric_Pad1.20x1.40mm_HandSolder; Mouser Part Number 660-RK73B2ATTD203J
R809: 4,7k; R_0805_2012Metric_Pad1.20x1.40mm_HandSolder; Mouser Part Number 279-CRG0805F4K7
R810, R811, R812: 10k; R_0805_2012Metric_Pad1.20x1.40mm_HandSolder; Mouser Part Number 660-RK73B2ATTD103G
R813: 732k; R_0805_2012Metric_Pad1.20x1.40mm_HandSolder; Mouser Part Number 603-RT0805FRE07732KL
U801: TPS61023DRLR; DRL0006A; Mouser Part Number 595-TPS61023DRLR
U802: ISL83078EIBZA; SOIC127P600X175-8N; Mouser Part Number 968-ISL83078EIBZA
X12: Conn_01x04_Pin; JST_XH_B4B-XH-AM_1x04_P2.50mm_Vertical; Mouser Part Number 306-B4BXHAMLFSNP
X13: Conn_01x07_Pin; JST_XH_B7B-XH-AM_1x07_P2.50mm_Vertical; Mouser Part Number 306-B7BXHAMLFSNP
X14, X15, X16, X17: Conn_01x03_Pin; JST_XH_B3B-XH-AM_1x03_P2.50mm_Vertical; Mouser Part Number 306-B3BXHAMLFSNP

Connections:
+3.3V: Q2.2 (S), Q801.2 (S), Q802.2 (S), Q803.2 (S), Q804.2 (S), Q805.2 (S), R20.2, R801.1, R804.2, R805.2, R806.2, R807.2, R809.2; also elsewhere on the board
/STM32U575ZIT6Q/BME_EN: Q804.1 (G), R806.1; also elsewhere on the board
/STM32U575ZIT6Q/DE/RE: R811.1, U802.2 (*RE), U802.3 (DE); also elsewhere on the board
/STM32U575ZIT6Q/I2C3_SCL: X13.4; also elsewhere on the board
/STM32U575ZIT6Q/I2C3_SDA: X13.2; also elsewhere on the board
/STM32U575ZIT6Q/PAR_EN: Q2.1 (G), R20.1; also elsewhere on the board
/STM32U575ZIT6Q/Signal_UV_radiation: X17.2; also elsewhere on the board
/STM32U575ZIT6Q/Signal_soil_moisture: X16.2; also elsewhere on the board
/STM32U575ZIT6Q/Signal_wind_velocity: X14.2; also elsewhere on the board
/STM32U575ZIT6Q/SoilMoist_EN: Q805.1 (G), R807.1; also elsewhere on the board
/STM32U575ZIT6Q/SoilTemp_EN: Q801.1 (G), R801.2; also elsewhere on the board
/STM32U575ZIT6Q/UART4_RX: R812.1, U802.1 (RO); also elsewhere on the board
/STM32U575ZIT6Q/UART4_TX: R810.1, U802.4 (DI); also elsewhere on the board
/STM32U575ZIT6Q/USART2_ONEWIRE: R809.1, X15.2; also elsewhere on the board
/STM32U575ZIT6Q/UV_EN: Q803.1 (G), R805.1; also elsewhere on the board
/STM32U575ZIT6Q/Wind_EN: Q802.1 (G), R804.1; also elsewhere on the board
/Sensors/3V3_PAR: C13.2, C801.2, L801.1, Q2.3 (D), R803.1, R810.2, R811.2, R812.2, U801.2 (EN), U801.3 (VIN), U802.8 (VCC)
/Sensors/5V: C812.2, C813.2, R813.1, U801.6 (VOUT), X12.1
GND: C13.1, C801.1, C802.1, C803.1, C804.1, C805.1, C806.1, C807.1, C808.1, C809.1, C810.1, C811.1, C812.1, C813.1, R808.2, R814.2, U801.4 (GND), U802.5 (GND), X12.4, X13.5, X14.3, X15.3; also elsewhere on the board
GNDA: X16.3, X17.3; also elsewhere on the board
unnamed: C802.2, C803.2, Q801.3 (D), X15.1
unnamed: C804.2, C808.2, Q802.3 (D), X14.1
unnamed: C805.2, C809.2, Q803.3 (D), X17.1
unnamed: C806.2, C810.2, Q804.3 (D), X13.7
unnamed: C807.2, C811.2, Q805.3 (D), X16.1
unnamed: R813.2, R814.1, U801.1 (FB)
unnamed: L801.2, U801.5 (SW)
unnamed: R802.2, R803.2, U802.6 (A/Y), X12.2
unnamed: R802.1, R808.1, U802.7 (B/Z), X12.3
unnamed: X13.3, X13.6

Notes on the sheet:
UV radiation sensor
Wind sensor
PAR-Sensor
BME680 Air-Sensor
Soil temperature
Soil moisture sensor

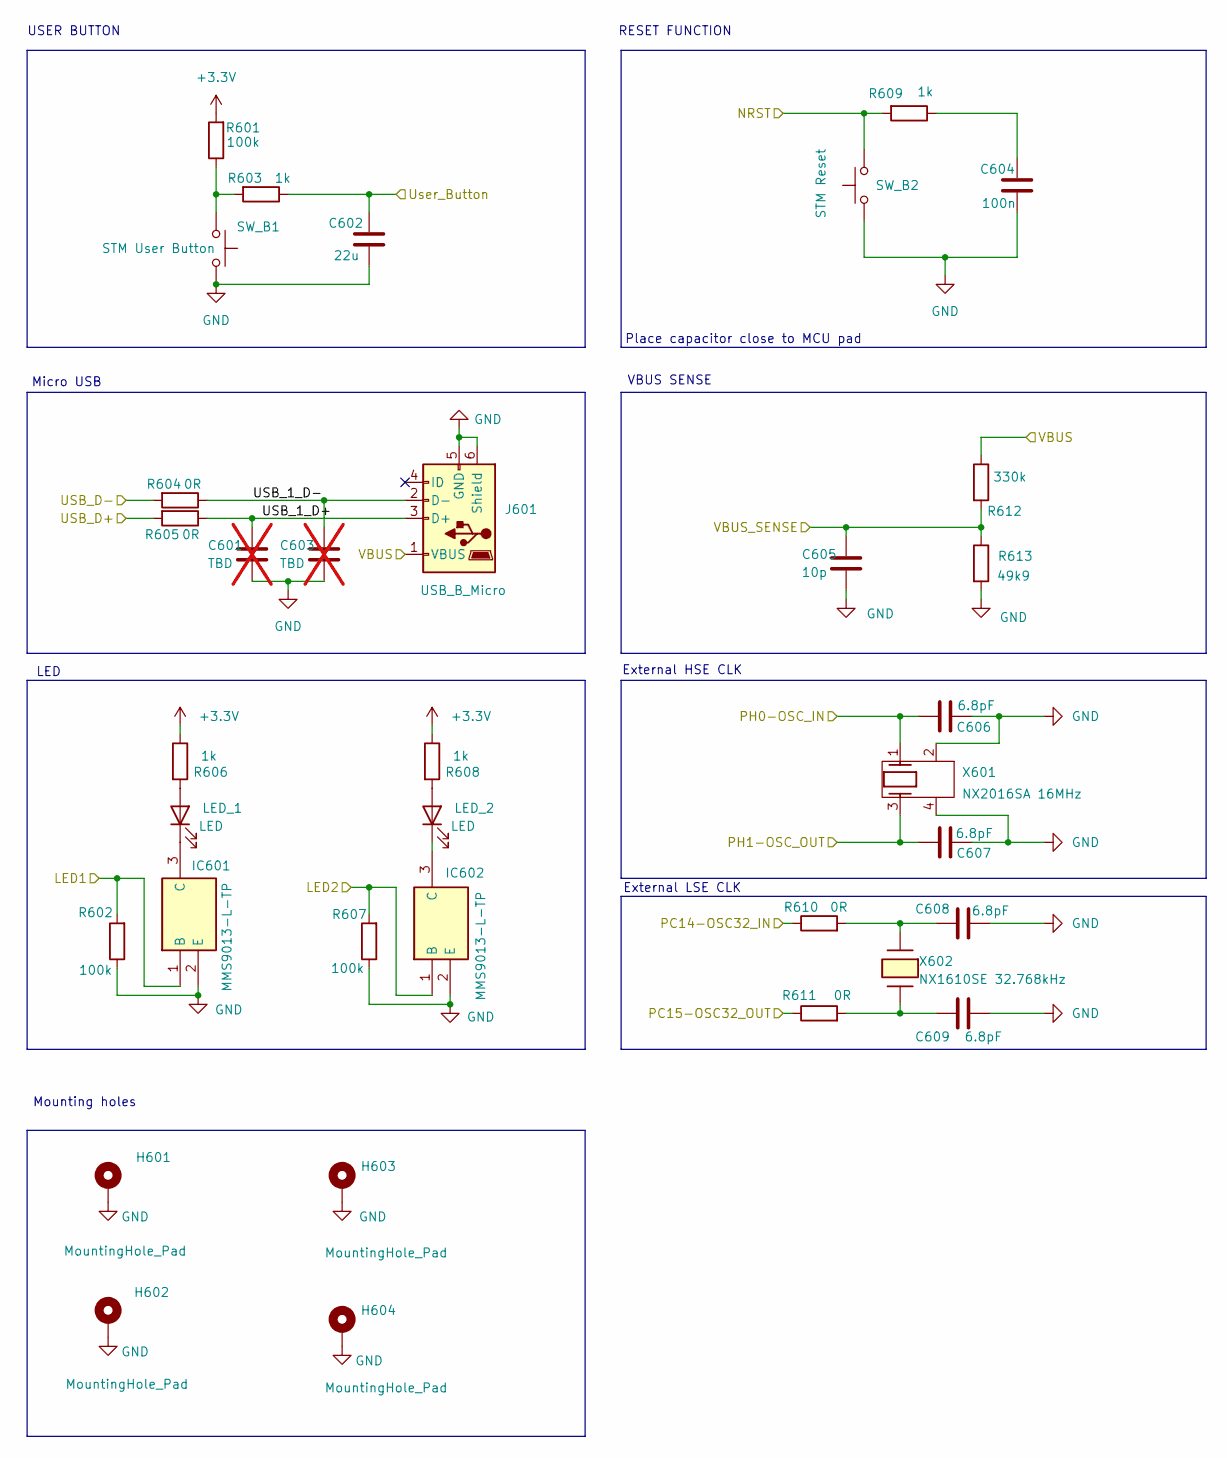
[picture p41: schematic OtherStuff.kicad_sch, GPIO and other stuff]

Parts:
C601, C603: TBD; C_0805_2012Metric_Pad1.18x1.45mm_HandSolder; not fitted
C602: 22u; C_0805_2012Metric_Pad1.18x1.45mm_HandSolder; Mouser Part Number 187-CL21A226KQCLRNC
C604: 100n; C_0805_2012Metric_Pad1.18x1.45mm_HandSolder; Mouser Part Number 603-CC805KRX7R9BB104
C605: 10p; C_0805_2012Metric_Pad1.18x1.45mm_HandSolder; Mouser Part Number 80-C0805C100JCRACTU
C606, C607, C608, C609: 6.8pF; C_0805_2012Metric_Pad1.18x1.45mm_HandSolder; Mouser Part Number 581-08055A6R8D
H601, H602, H603, H604: MountingHole_Pad; MountingHole_2.2mm_M2_DIN965_Pad
IC601, IC602: MMS9013-L-TP; SOT95P237X125-3N; Mouser Part Number 833-MMS9013L-TP
J601: USB_B_Micro; USB_Micro-B_Amphenol_10103594-0001LF_Horizontal; Mouser Part Number 649-10103594-0001LF
LED_1, LED_2: LED; LED_0805_2012Metric_Pad1.15x1.40mm_HandSolder; Mouser Part Number 630-HSME-C170
R601, R602, R607: 100k; R_0805_2012Metric_Pad1.20x1.40mm_HandSolder; Mouser Part Number 660-RK73B2ATTE104J
R603, R606, R608, R609: 1k; R_0805_2012Metric_Pad1.20x1.40mm_HandSolder; Mouser Part Number 667-ERJ-6ENF1001V
R604, R605, R610, R611: 0R; R_0805_2012Metric_Pad1.20x1.40mm_HandSolder; Mouser Part Number 279-CRG0805ZR
R612: 330k; R_0805_2012Metric_Pad1.20x1.40mm_HandSolder; Mouser Part Number 652-CR0805AFX3303EAS
R613: 49k9; R_0805_2012Metric_Pad1.20x1.40mm_HandSolder; Mouser Part Number 594-MCU08050D4992BP5
SW_B1, SW_B2: SW_Push; SW_Push_SPST_NO_Alps_SKRK; Mouser Part Number 688-SKRKAG
X601: XTAL_4_PINS; NX2016SA32MEXS00ACS06465; PART_TYPE Crystal_Osc; Mouser Part Number 344-NX1610SA32768000
X602: XTAL_2_PINS; NX1610SA32768000kHz; PART_TYPE Crystal_Osc

Connections:
+3.3V: R601.2, R606.1, R608.1; also elsewhere on the board
/IO and mounting holes/LED1: IC601.1 (B), R602.2; also elsewhere on the board
/IO and mounting holes/LED2: IC602.1 (B), R607.2; also elsewhere on the board
/IO and mounting holes/PC14-OSC32_IN: R610.1; also elsewhere on the board
/IO and mounting holes/PC15-OSC32_OUT: R611.1; also elsewhere on the board
/IO and mounting holes/PH0-OSC_IN: C606.2, X601.1; also elsewhere on the board
/IO and mounting holes/PH1-OSC_OUT: C607.2, X601.3; also elsewhere on the board
/IO and mounting holes/USB_1_D+: C601.2, J601.3 (D+), R605.1
/IO and mounting holes/USB_1_D-: C603.2, J601.2 (D-), R604.1
/IO and mounting holes/USB_D+: R605.2; also elsewhere on the board
/IO and mounting holes/USB_D-: R604.2; also elsewhere on the board
/IO and mounting holes/User_Button: C602.2, R603.1; also elsewhere on the board
/IO and mounting holes/VBUS: J601.1 (VBUS), R612.1; also elsewhere on the board
/IO and mounting holes/VBUS_SENSE: C605.2, R612.2, R613.1; also elsewhere on the board
/STM32U575ZIT6Q/NRST: R609.2, SW_B2.2; also elsewhere on the board
GND: C601.1, C602.1, C603.1, C604.1, C605.1, C606.1, C607.1, C608.1, C609.1, H601.1, H602.1, H603.1, H604.1, IC601.2 (E), IC602.2 (E), J601.5 (GND), J601.6 (Shield), R602.1, R607.1, R613.2, SW_B1.2, SW_B2.1, X601.2, X601.4; also elsewhere on the board
unnamed: C604.2, R609.1
unnamed: IC601.3 (C), LED_1.1 (K)
unnamed: IC602.3 (C), LED_2.1 (K)
unnamed: LED_1.2 (A), R606.2
unnamed: LED_2.2 (A), R608.2
unnamed: R601.1, R603.2, SW_B1.1
unnamed: C609.2, R611.2, X602.1 (X1)
unnamed: C608.2, R610.2, X602.2 (X2)

Notes on the sheet:
USER BUTTON
External HSE CLK
VBUS SENSE
Place capacitor close to MCU pad
External LSE CLK
Mounting holes
Micro USB
RESET FUNCTION
LED

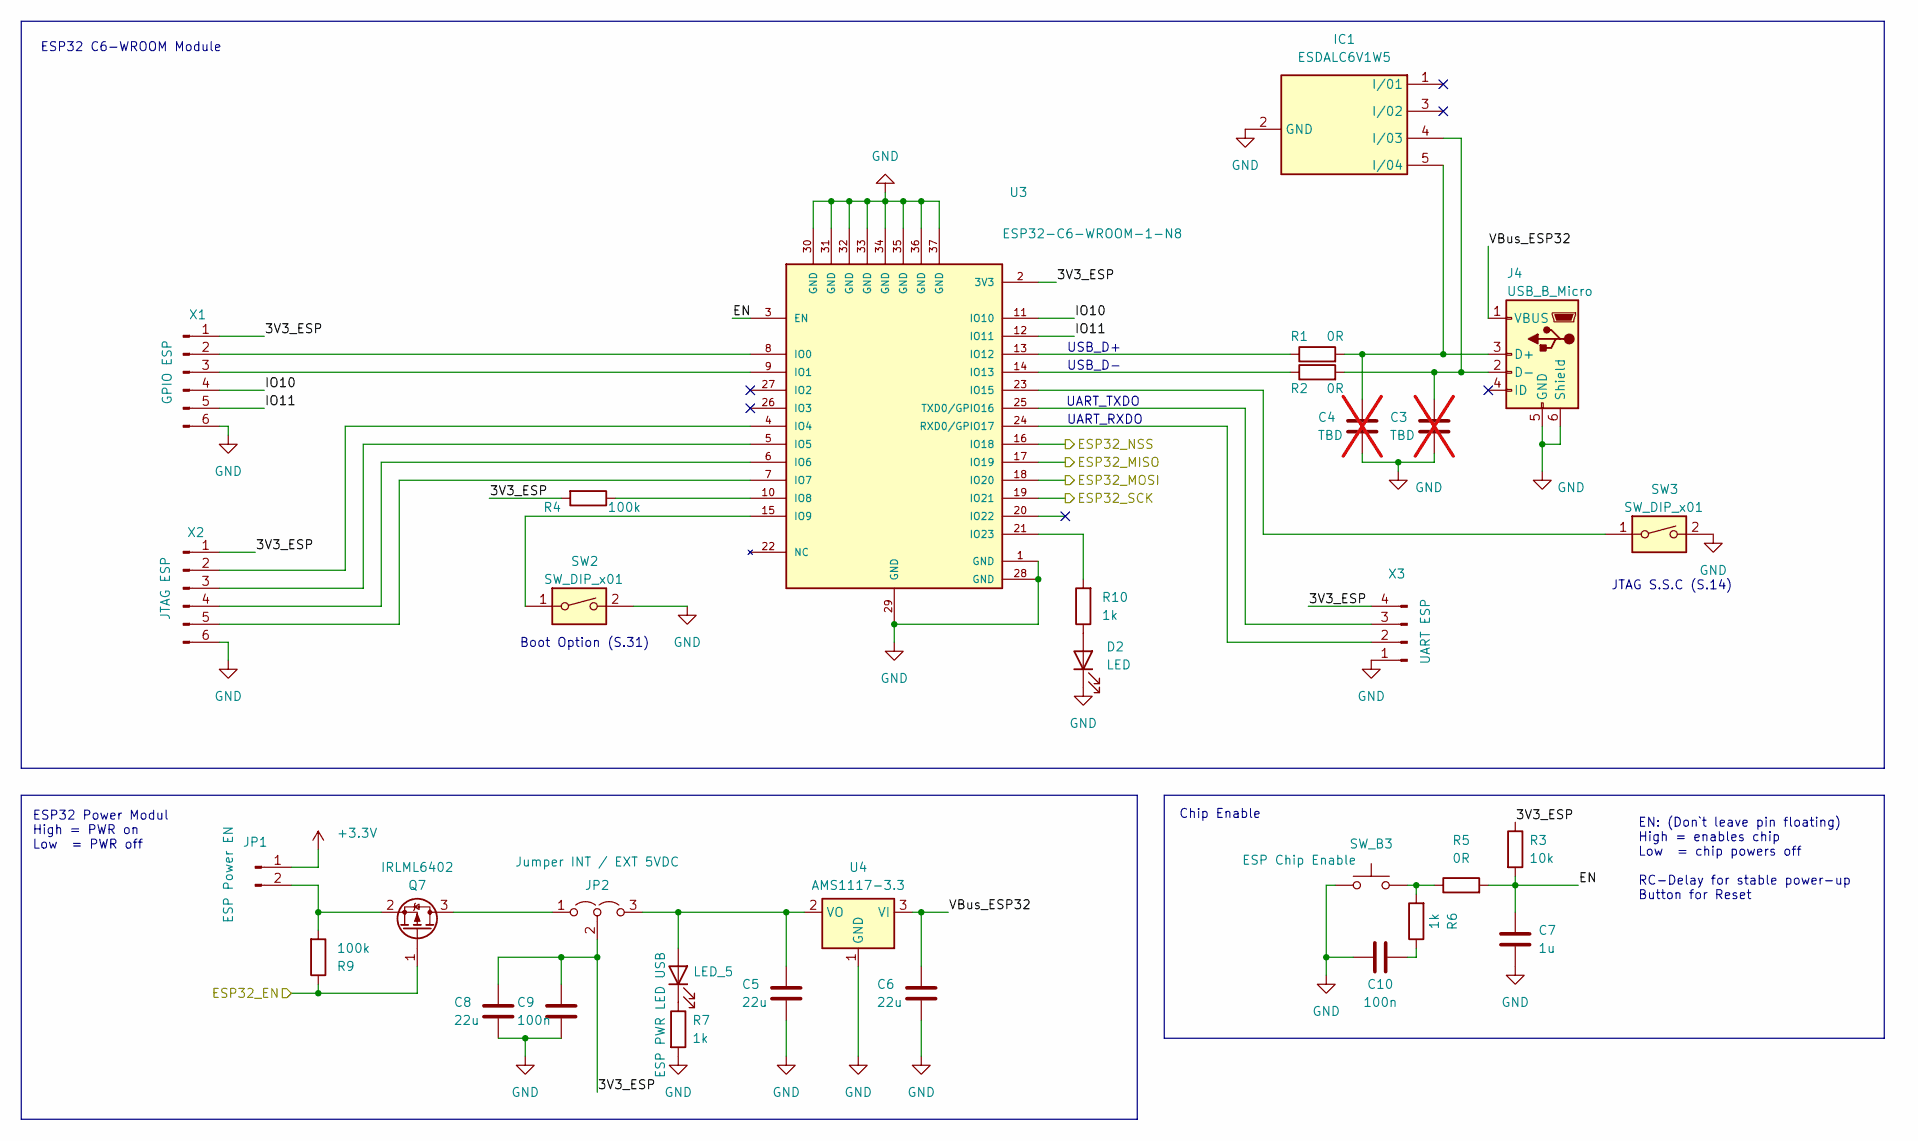
[picture p42: schematic ESP32.kicad_sch, ESP32-C6-WROOM-1-N8]

Parts:
C3, C4: TBD; C_0805_2012Metric_Pad1.18x1.45mm_HandSolder; not fitted
C5, C6, C8: 22u; C_0805_2012Metric_Pad1.18x1.45mm_HandSolder; Mouser Part Number 187-CL21A226KQCLRNC
C7: 1u; C_0805_2012Metric_Pad1.18x1.45mm_HandSolder; Mouser Part Number 80-C0805C105K3RACTM
C9, C10: 100n; C_0805_2012Metric_Pad1.18x1.45mm_HandSolder; Mouser Part Number 603-CC805KRX7R9BB104
D2: LED; LED_0805_2012Metric_Pad1.15x1.40mm_HandSolder; Mouser Part Number 630-HSME-C170
IC1: ESDALC6V1W5; SOT65P210X110-5N; Mouser Part Number 511-ESDALC6V1W5
J4: USB_B_Micro; USB_Micro-B_Amphenol_10103594-0001LF_Horizontal; Mouser Part Number 649-10103594-0001LF
JP1: Conn_01x02_Pin; PinHeader_1x02_P2.54mm_Vertical; Mouser Part Number 523-G800NA306018EU
JP2: Jumper_3_Open; PinHeader_1x03_P2.54mm_Vertical; Mouser Part Number 649-1012937890304BLF
LED_5: LED; LED_0805_2012Metric_Pad1.15x1.40mm_HandSolder; Mouser Part Number 630-HSME-C170
Q7: IRLML6402; SOT-23; Mouser Part Number 942-IRLML6402TRPBF
R1, R2, R5: 0R; R_0805_2012Metric_Pad1.20x1.40mm_HandSolder; Mouser Part Number 279-CRG0805ZR
R3: 10k; R_0805_2012Metric_Pad1.20x1.40mm_HandSolder; Mouser Part Number 660-RK73B2ATTD103G
R4, R9: 100k; R_0805_2012Metric_Pad1.20x1.40mm_HandSolder; Mouser Part Number 660-RK73B2ATTE104J
R6, R7, R10: 1k; R_0805_2012Metric_Pad1.20x1.40mm_HandSolder; Mouser Part Number 667-ERJ-6ENF1001V
SW2, SW3: SW_DIP_x01; SW_DIP_SPSTx01_Slide_6.7x4.1mm_W6.73mm_P2.54mm_LowProfile_J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; Mouser Part Number 490-DS04254201BK-SMT
SW_B3: SW_Push; SW_Push_SPST_NO_Alps_SKRK; Mouser Part Number 688-SKRKAG
U3: ESP32-C6-WROOM-1-N8; ESP32C6WROOM1N8; PARTREV 1.0; Mouser Part Number 356-ESP32C6WROOM1N8
U4: AMS1117-3.3; SOT-223-3_TabPin2; Mouser Part Number 926-LM1117MP-3.3NOPB
X1, X2: Conn_01x06_Pin; PinHeader_1x06_P2.54mm_Vertical; Mouser Part Number 649-1012937990602BLF
X3: Conn_01x04_Pin; PinHeader_1x04_P2.54mm_Vertical; Mouser Part Number 523-G800LW304032EU

Connections:
+3.3V: JP1.1; also elsewhere on the board
/ESP32-C6-WROOM-1-N8/3V3_ESP: C8.2, C9.2, JP2.2 (C), R3.1, R4.2, U3.2 (3V3), X1.1, X2.1, X3.4
/ESP32-C6-WROOM-1-N8/EN: C7.2, R3.2, R5.2, U3.3 (EN)
/ESP32-C6-WROOM-1-N8/ESP32_EN: Q7.1 (G), R9.1; also elsewhere on the board
/ESP32-C6-WROOM-1-N8/ESP32_MISO: U3.17 (IO19); also elsewhere on the board
/ESP32-C6-WROOM-1-N8/ESP32_MOSI: U3.18 (IO20); also elsewhere on the board
/ESP32-C6-WROOM-1-N8/ESP32_NSS: U3.16 (IO18); also elsewhere on the board
/ESP32-C6-WROOM-1-N8/ESP32_SCK: U3.19 (IO21); also elsewhere on the board
/ESP32-C6-WROOM-1-N8/IO10: U3.11 (IO10), X1.4
/ESP32-C6-WROOM-1-N8/IO11: U3.12 (IO11), X1.5
/ESP32-C6-WROOM-1-N8/VBus_ESP32: C6.2, J4.1 (VBUS), U4.3 (VI)
GND: C3.1, C4.1, C5.1, C6.1, C7.1, C8.1, C9.1, C10.1, D2.1 (K), IC1.2 (GND), J4.5 (GND), J4.6 (Shield), R7.2, SW2.2, SW3.2, SW_B3.1, U3.1 (GND), U3.28 (GND), U3.29 (GND), U3.30 (GND), U3.31 (GND), U3.32 (GND), U3.33 (GND), U3.34 (GND), U3.35 (GND), U3.36 (GND), U3.37 (GND), U4.1 (GND), X1.6, X2.6, X3.1; also elsewhere on the board
unnamed: C10.2, R6.1
unnamed: D2.2 (A), R10.1
unnamed: C3.2, IC1.4 (I/03), J4.2 (D-), R2.2
unnamed: C4.2, IC1.5 (I/04), J4.3 (D+), R1.2
unnamed: JP1.2, Q7.2 (S), R9.2
unnamed: JP2.1 (A), Q7.3 (D)
unnamed: C5.2, JP2.3 (B), LED_5.2 (A), U4.2 (VO)
unnamed: LED_5.1 (K), R7.1
unnamed: R5.1, R6.2, SW_B3.2
unnamed: U3.8 (IO0), X1.2
unnamed: U3.9 (IO1), X1.3
unnamed: U3.4 (IO4), X2.2
unnamed: U3.5 (IO5), X2.3
unnamed: U3.6 (IO6), X2.4
unnamed: U3.7 (IO7), X2.5
unnamed: R4.1, U3.10 (IO8)
unnamed: SW2.1, U3.15 (IO9)
unnamed: R1.1, U3.13 (IO12)
unnamed: R2.1, U3.14 (IO13)
unnamed: SW3.1, U3.23 (IO15)
unnamed: R10.2, U3.21 (IO23)
unnamed: U3.24 (RXD0/GPIO17), X3.2
unnamed: U3.25 (TXD0/GPIO16), X3.3

Notes on the sheet:
JTAG S.S.C (S.14)
USB_D+
ESP32 C6-WROOM Module
Chip Enable
EN: (Don`t leave pin floating) High = enables chip Low = chip powers off RC-Delay for stable power-up Button for Reset
UART_RXDO
ESP32 Power Modul High = PWR on Low = PWR off
UART_TXDO
USB_D-
Boot Option (S.31)

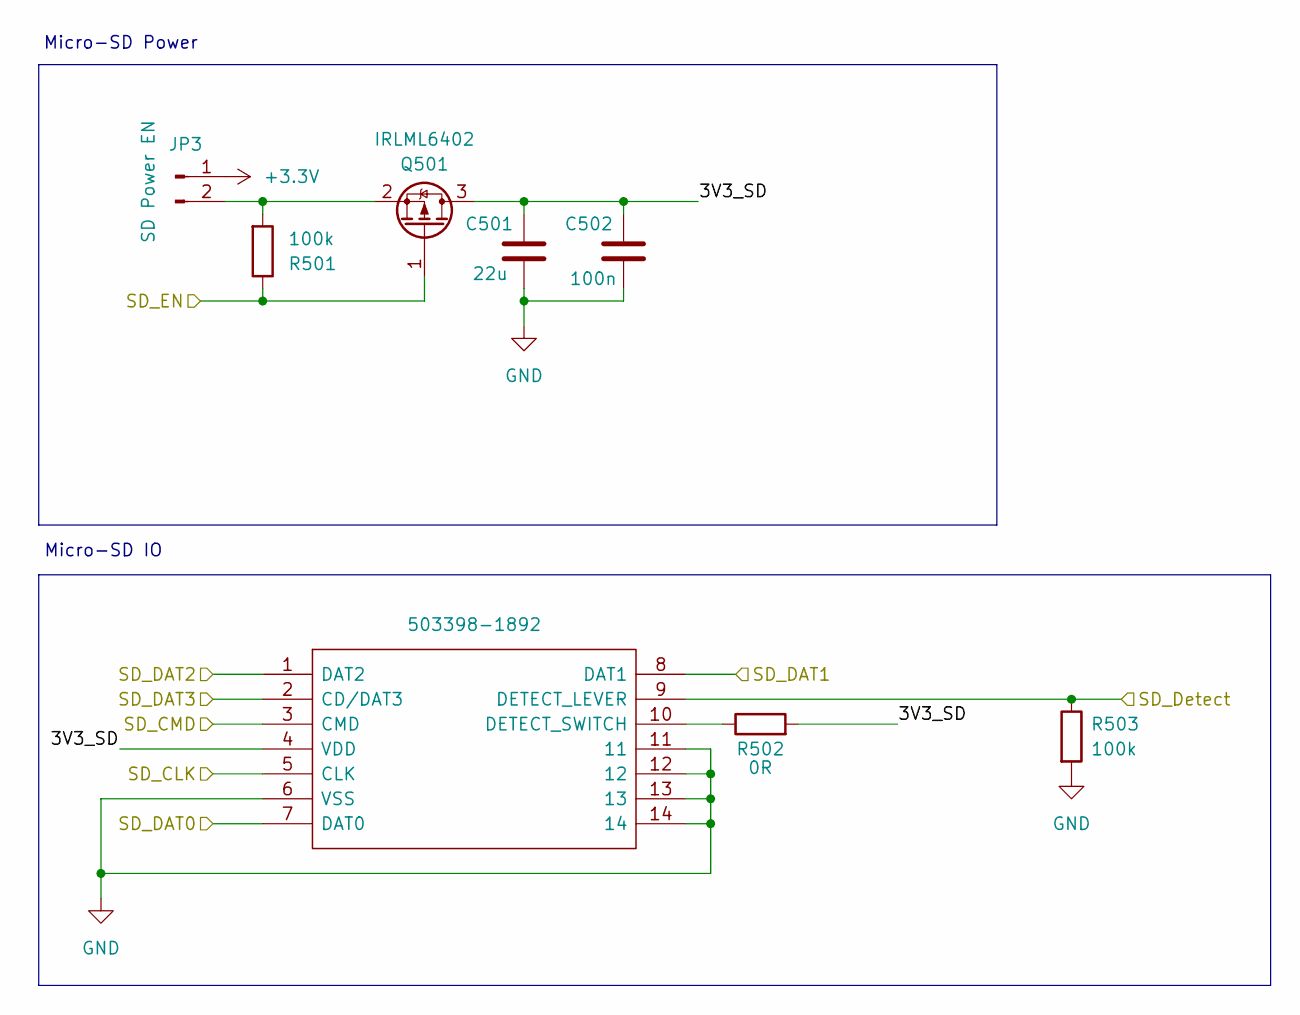
[picture p43: schematic Micro-SD.kicad_sch, Micro-SD Reader]

Parts:
C501: 22u; C_0805_2012Metric_Pad1.18x1.45mm_HandSolder; Mouser Part Number 187-CL21A226KQCLRNC
C502: 100n; C_0805_2012Metric_Pad1.18x1.45mm_HandSolder; Mouser Part Number 603-CC805KRX7R9BB104
J502: 503398-1892; 503398-1892-1; Mouser Part Number 538-503398-1892
JP3: Conn_01x02_Pin; PinHeader_1x02_P2.54mm_Vertical; Mouser Part Number 523-G800NA306018EU
Q501: IRLML6402; SOT-23; Mouser Part Number 942-IRLML6402TRPBF
R501, R503: 100k; R_0805_2012Metric_Pad1.20x1.40mm_HandSolder; Mouser Part Number 660-RK73B2ATTE104J
R502: 0R; R_0805_2012Metric_Pad1.20x1.40mm_HandSolder; Mouser Part Number 279-CRG0805ZR

Connections:
+3.3V: JP3.1; also elsewhere on the board
/Micro SD-Card Reader 503398-1892/3V3_SD: C501.2, C502.2, J502.4 (VDD), Q501.3 (D), R502.2
/Micro SD-Card Reader 503398-1892/SD_CLK: J502.5 (CLK); also elsewhere on the board
/Micro SD-Card Reader 503398-1892/SD_CMD: J502.3 (CMD); also elsewhere on the board
/Micro SD-Card Reader 503398-1892/SD_DAT0: J502.7 (DAT0); also elsewhere on the board
/Micro SD-Card Reader 503398-1892/SD_DAT1: J502.8 (DAT1); also elsewhere on the board
/Micro SD-Card Reader 503398-1892/SD_DAT2: J502.1 (DAT2); also elsewhere on the board
/Micro SD-Card Reader 503398-1892/SD_DAT3: J502.2 (CD/DAT3); also elsewhere on the board
/Micro SD-Card Reader 503398-1892/SD_Detect: J502.9 (DETECT_LEVER), R503.1; also elsewhere on the board
/Micro SD-Card Reader 503398-1892/SD_EN: Q501.1 (G), R501.1; also elsewhere on the board
GND: C501.1, C502.1, J502.6 (VSS), J502.11, J502.12, J502.13, J502.14, R503.2; also elsewhere on the board
unnamed: J502.10 (DETECT_SWITCH), R502.1
unnamed: JP3.2, Q501.2 (S), R501.2

Notes on the sheet:
Micro-SD Power
Micro-SD IO

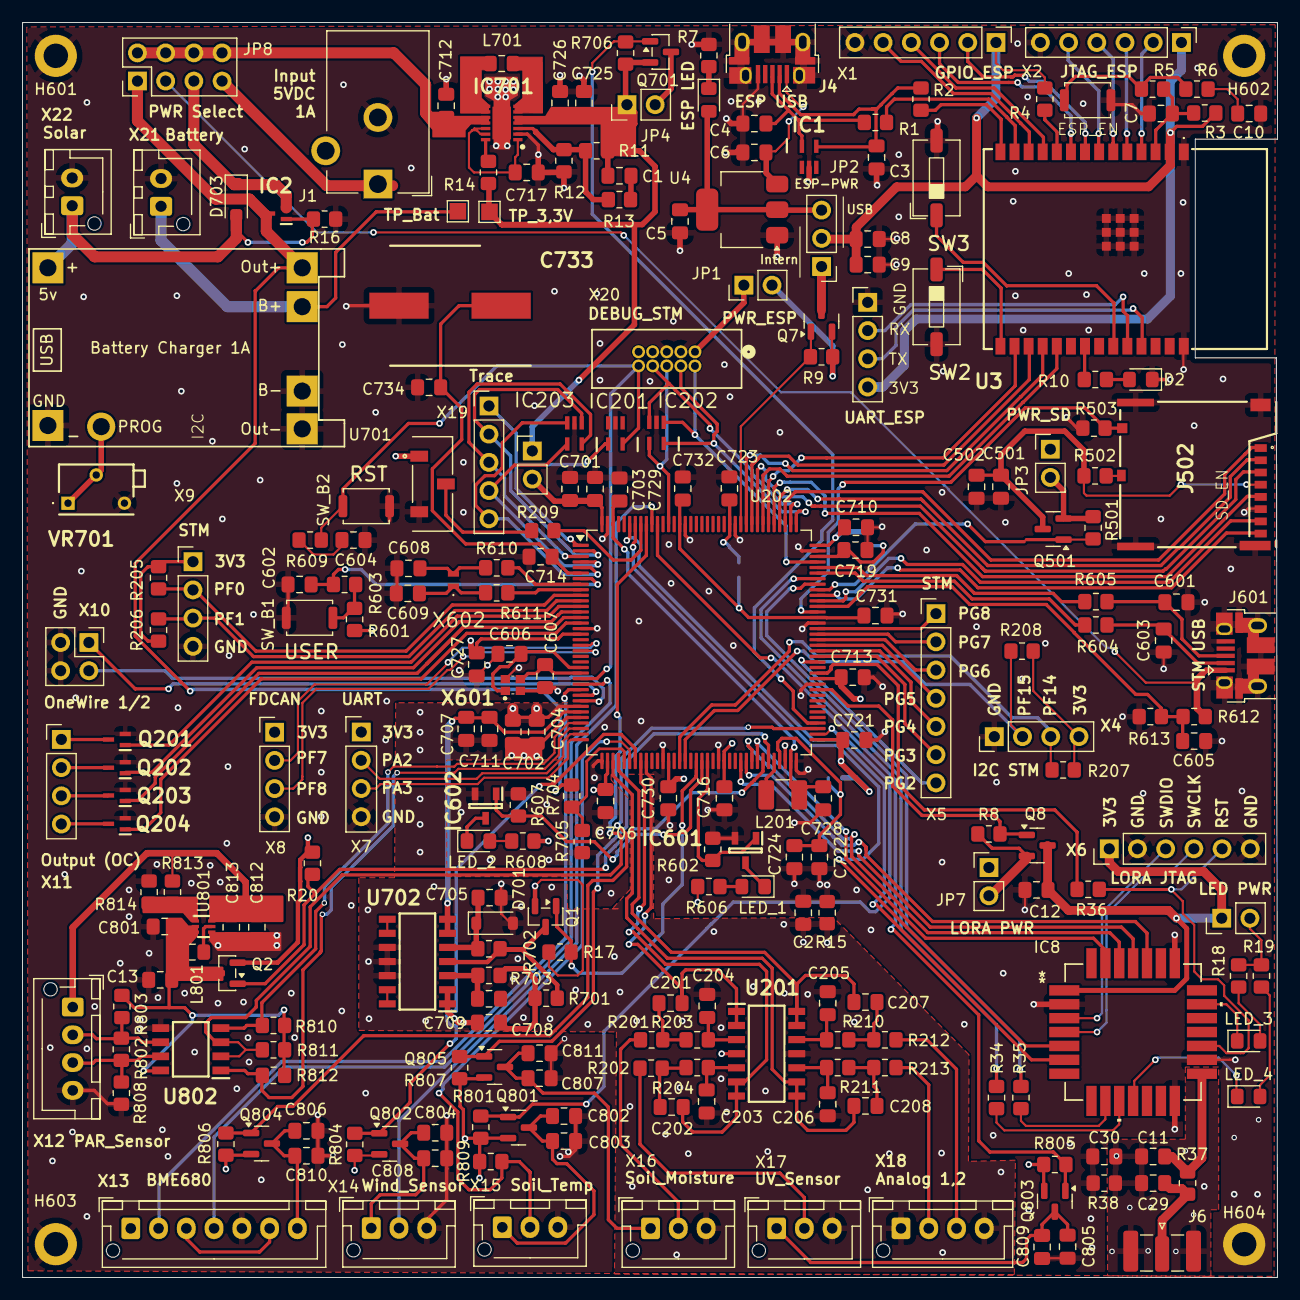
[picture p44: board uC_Agri-PV.kicad_pcb from above]

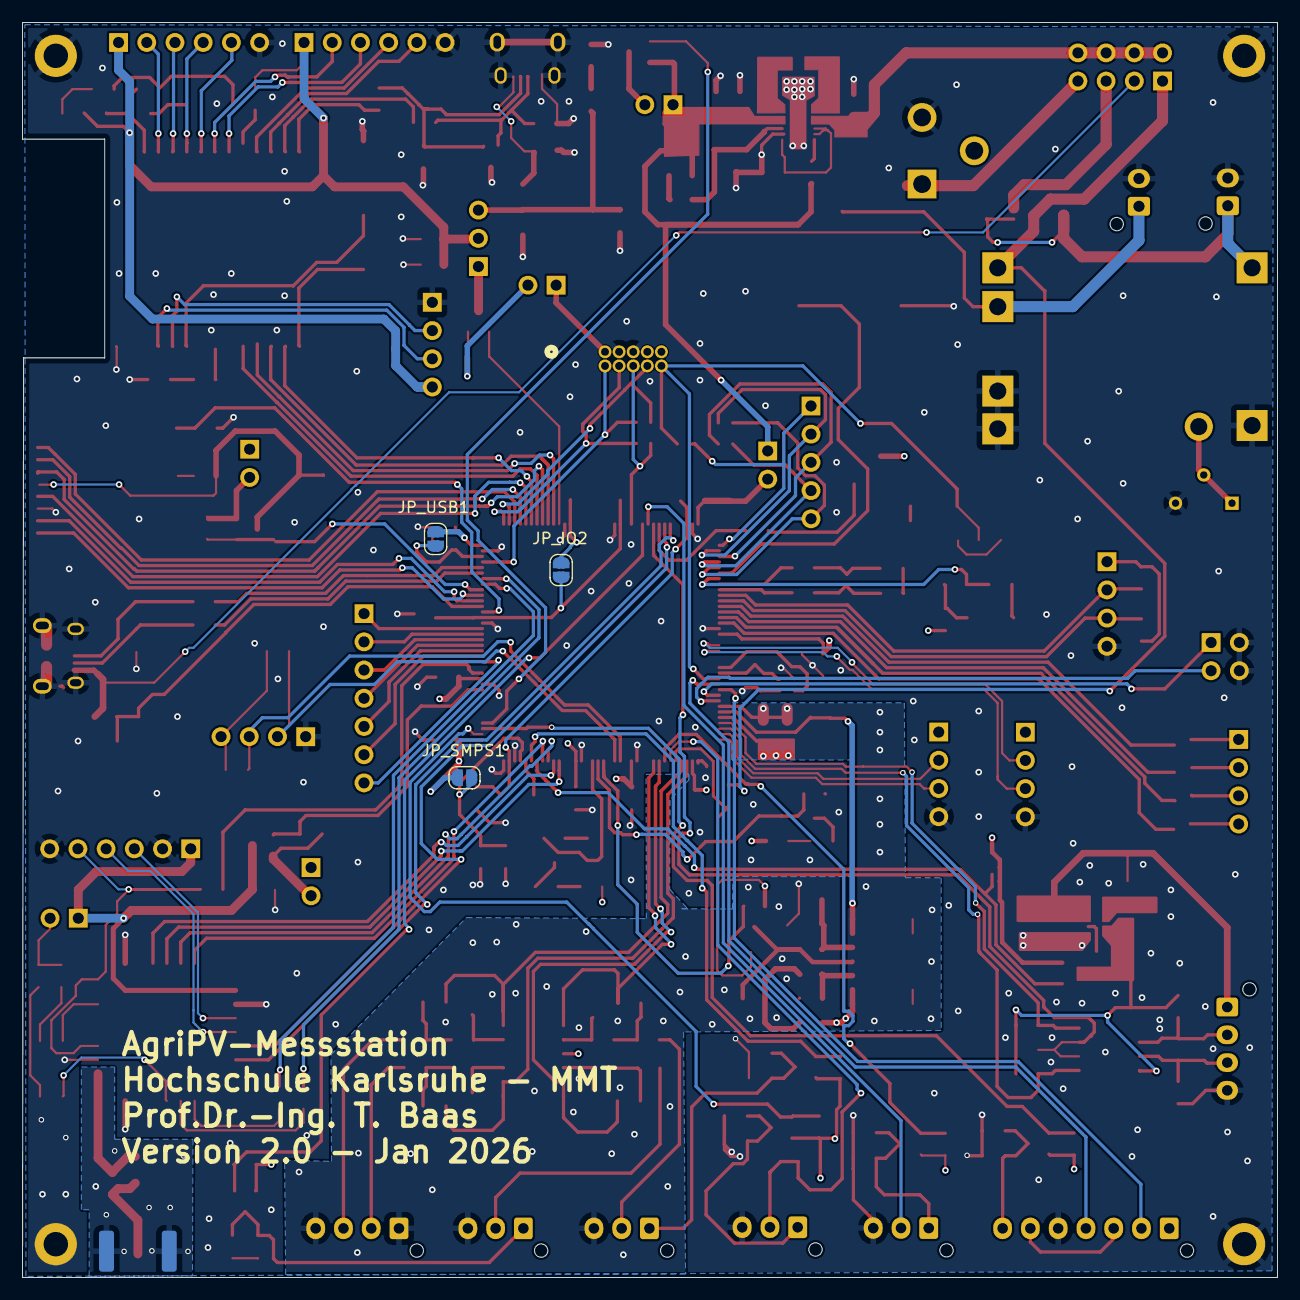
[picture p45: board uC_Agri-PV.kicad_pcb from below]

Board: 4 copper layers, 113.0 x 113.0 mm, 248 parts (3 on the bottom side), 203 nets.
