DerSchweigefuchs/uC_Agri-PV/(commit log)

2025-12-17 Incorporation of the project of the predecessor of revision v1.1
    [317990687.stp, 3266x1203lf.psm, 503398-1892.psm, 503398-1892.stp, BD125-10-A-0305-0580-L-B.stp, CONSMA001-SMD-G-T.stp, DMG1012T-13.stp, EDI2CAP.CFG]
2025-12-17 Add FC0V104ZFTBR24 component library files
    Added symbol, footprint, 3D model, and documentation files for the Supercap (FC0V104ZFTBR24) component across multiple EDA tool formats. Also updated schematic files and project backups, and removed obsolete autosave and backup files.
    [CAPAE1080X550N.PcbLib, EDI2CAP.CFG, FC0V104ZFTBR24.SchLib, FC0V104ZFTBR24.stp, OtherStuff.kicad_sch, Power.kicad_sch, STM32.kicad_sch, capae1080x550n.psm]
2025-12-18 Add TP4056-18650 footprint and update Power schematic
    Added the TP4056-18650-2 footprint to the library and assigned it to the battery charger in Power.kicad_sch. Updated the Power schematic to improve symbol details, add descriptive properties, and enhance the 3V3 lane toggling section. Made various net and annotation adjustments, and removed obsolete autosave and lock files.
    [Power.kicad_sch, STM32.kicad_sch, µC_Agri-PV.kicad_pcb, µC_Agri-PV.kicad_sch]
2025-12-18 Update schematic and PCB version to 1.3, update dates
    Updated revision numbers and dates to 2025-12-18 (version 1.3) across all KiCad schematic files and the PCB. Adjusted the board text to reflect the new version and date. Also updated backup ZIP file and made a minor property fix in Power.kicad_sch.
    [ESP32.kicad_sch, LoRa.kicad_sch, Micro-SD.kicad_sch, OtherStuff.kicad_sch, Power.kicad_sch, STM32.kicad_sch, sensors.kicad_sch, µC_Agri-PV.kicad_pcb]
2026-01-08 new layout
    - recreation of the layout
    - changed connection of ADC to MCU
    - cleaner layout
    - battery (supercap) for rtc
    - crystal nearby the mcu
    - 3V3 layer can be switched on/off separated from the mcu
    - diode replaced with MOSFET
    [317990687.PcbLib, 317990687.SchLib, 503398-1892.SchLib, 503398-1892.psm, 503398-1892.stp, 5033981892.PcbLib, 5033981892.psm, DMP1045U-7.SchLib]
2026-01-08 step file for Lora E5 module
    [317990687.PcbLib, 317990687.SchLib, 317990687.stp, EDI2CAP.CFG, chips.prt, uC_Agri-PV.kicad_pcb]
2026-01-08 Update schematics to revision 2.0 and adjust Micro-SD layout
    Bump revision and date to 2.0 (2026-01-08) in all schematic sheets. Adjust wire and label positions in Micro-SD.kicad_sch and update R502 reference/value locations. Regenerate iBOM HTML.
    [ESP32.kicad_sch, LoRa.kicad_sch, Micro-SD.kicad_sch, OtherStuff.kicad_sch, Power.kicad_sch, STM32.kicad_sch, sensors.kicad_sch, uC_Agri-PV.kicad_sch]
2026-01-08 Add new ECAD part library files for 317990687
    Added multiple ECAD model files, 3D STEP file, documentation, and part information for component 317990687 across various EDA tool formats. Also removed auto-saved and backup files related to sensors and updated fp-info-cache.
    [317990687.PcbLib, 317990687.SchLib, 317990687.stp, EDI2CAP.CFG, chips.prt, uC_Agri-PV.kicad_pcb]
2026-01-08 Add free via at (33, 75) on PCB layout
    Inserted a new free via with 2mm size and 1.8mm drill at coordinates (33, 75) in the uC_Agri-PV.kicad_pcb file. Updated the .kicad_prl file to reflect changes in active and visible layers.
    [uC_Agri-PV.kicad_pcb]
2026-01-09 Add v2.0 redesign files and documentation
    Introduced a complete hardware redesign for the uC_Agri-PV board (v2.0), including new KiCad PCB layout, updated schematic, and new documentation files: README.md, HARDWARE_PINOUT.md, and updated CHANGELOG.md. Added pinout diagram and PCB images for project documentation. Removed obsolete backup and updated project metadata to reflect the new version.
2026-01-09 Clean up ignored files and update documentation
    Removed .DS_Store, KiCad backup, and autosave files from the repository. Expanded .gitignore to cover KiCad, OS, IDE, and temporary files. Updated CHANGELOG.md to English for v2.0 and improved clarity. No functional code changes.
2026-01-10 Remove unnecessary files from tracking and update .gitignore
    - Remove backup files (*.kicad_sch-bak, *-backups/)
    - Remove autosave files (*_autosave*)
    - Remove local settings (*.kicad_prl)
    - Remove OS system files (.DS_Store)
    - Update .gitignore to prevent future tracking
2026-01-10 Update README BOM link and regenerate ibom.html
    Changed the Interactive BOM link in README.md to point to the hosted GitHub Pages version. Regenerated bom/ibom.html and updated uC_Agri-PV.kicad_pro, likely reflecting recent board or BOM changes.
2026-01-10 Update sensor table and version info in docs
    Revised the sensor table in README.md to reflect updated interfaces and removed the connector column. Updated version dates and notes in CHANGELOG.md for clarity. Also made minor corrections to documentation wording and removed the 'Getting Started' section from the README.
2026-01-12 Add power control documentation and update image paths
    Introduced POWER_CONTROL.md with detailed board power management instructions. Updated README.md to reference the new documentation and moved image files to the images/ directory, adjusting paths accordingly. Added new images for power selection and reorganized existing images for clarity.
2026-01-12 Update hardware docs: clarify power lanes and enable signals
    Added diagram and detailed explanation of 3.3V lane control in POWER_CONTROL.md, including new image. Updated HARDWARE_PINOUT.md to clarify that all enable signals are active LOW and corrected the enable table. Removed redundant pin definition section from README.md. Added supporting files for documentation.
2026-01-14 Update wind speed sensor to digital frequency input
    Revised HARDWARE_PINOUT.md to reflect the change from RS485 (UART4) to a digital frequency input (TIM4_CH1) for the wind speed sensor (SEN0170), including updated pin assignments and data flow. Modified Power.kicad_sch to adjust related wiring and component positions. Cleaned up .gitignore and removed temporary and autosave files.
    [Power.kicad_sch]
2026-01-14 Document power supply chain and add circuit diagrams
    Expanded POWER_CONTROL.md to describe the two-stage power architecture using TP4056 and TPS63021 components. Added circuit diagrams for the battery charger and buck-boost converter to the images directory. Updated power source selection table and descriptions for clarity.
2026-01-14 Update V2_0_Pin_definition.png image
    Replaces the existing V2_0_Pin_definition.png with a new version. This may reflect updated pin definitions or improved image clarity.
2026-01-20 Zwei falsche Vias (Achtung Kurzschluss) entfernt und Beschriftung STM-UART Stiftleisten und USB-Anschlüsse angepasst
    [uC_Agri-PV.kicad_pcb]
2026-01-20 Änderung Beschriftungen und Drehung X8 (3V3 gleich zu X7)
    [uC_Agri-PV.kicad_pcb]
2026-01-22 Änderungen an Bauteilbezeichnungen (nur optisch, nicht technisch) Bestellung PCB Jan 26 MultiCP
    [uC_Agri-PV.kicad_pcb]
