DerSchweigefuchs/uC_Agri-PV/(notices)

Notices in the files:
Bibliothek/LIB_BD125-10-A-0305-0580-L-B/BD125-10-A-0305-0580-L-B/3D/BD125-10-A-0305-0580-L-B.stp:
author */ ('License CC BY-ND 4.0'),
